custom-ds/ptFlex/assets/pcb-board-rendering.png

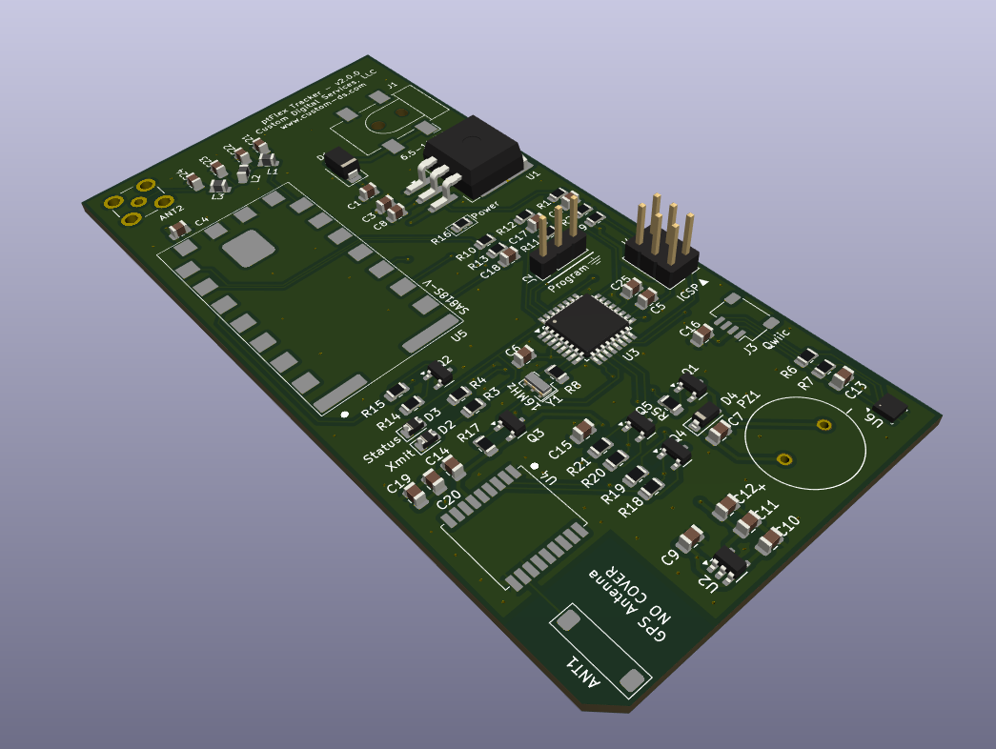
assets/pcb-board-rendering.png
