custom-ds/ptFlex/README.md

# ptFlex
ptFlex tracker board starting with version 2.0 of the hardware, which is based on the improvements found in the ptSolar tracker. This repo supercedes the original ptFlex-firmware and ptFlex-Hardware repos from the version 1.0 hardware.
