custom-ds/ptFlex/ptFlex/v1.0.4/README.md

# ptFlex v1.0.4

Final version of the 1.0 line of trackers, from the ptFlex-hardware project Repo on Github. The version 2.0 is an evolution of 1.0, but includes a new GPS engine, more readily available GPS antennas, and the circuit has been ported over to KiCad.
