custom-ds/ptFlex/assets/arduino-boards-manager2.png

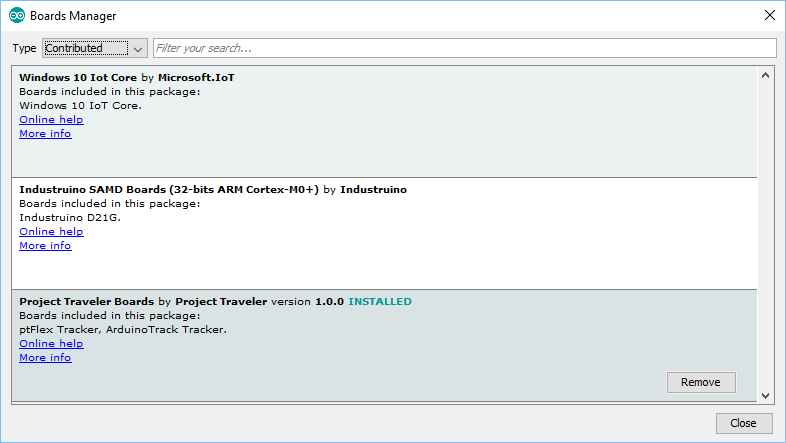
assets/arduino-boards-manager2.png
