custom-ds/ptFlex/assets/arduino-boards-manager-url.png

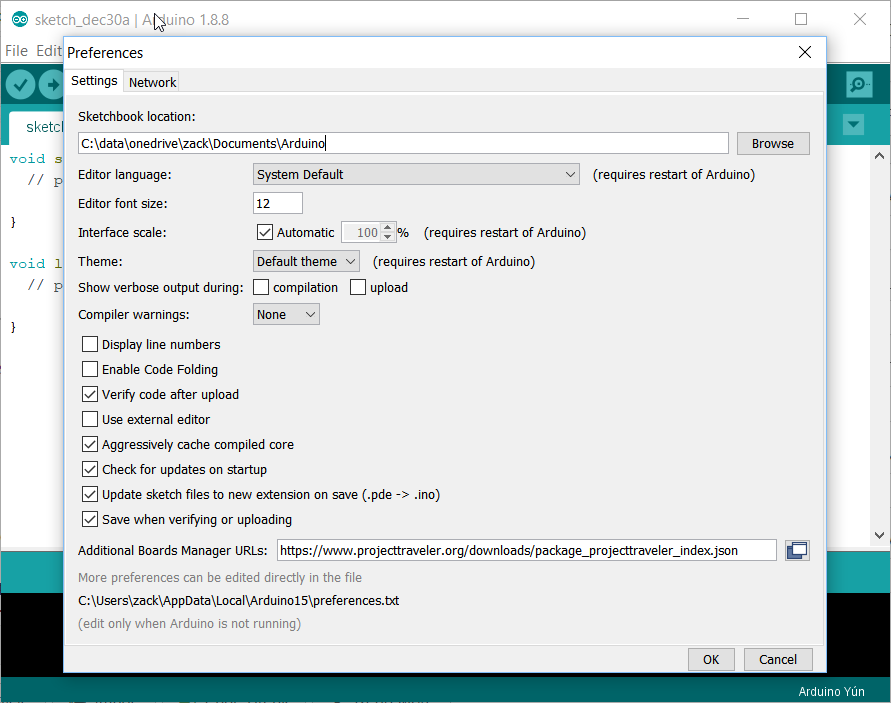
assets/arduino-boards-manager-url.png
