custom-ds/ptFlex/assets/schematic.png

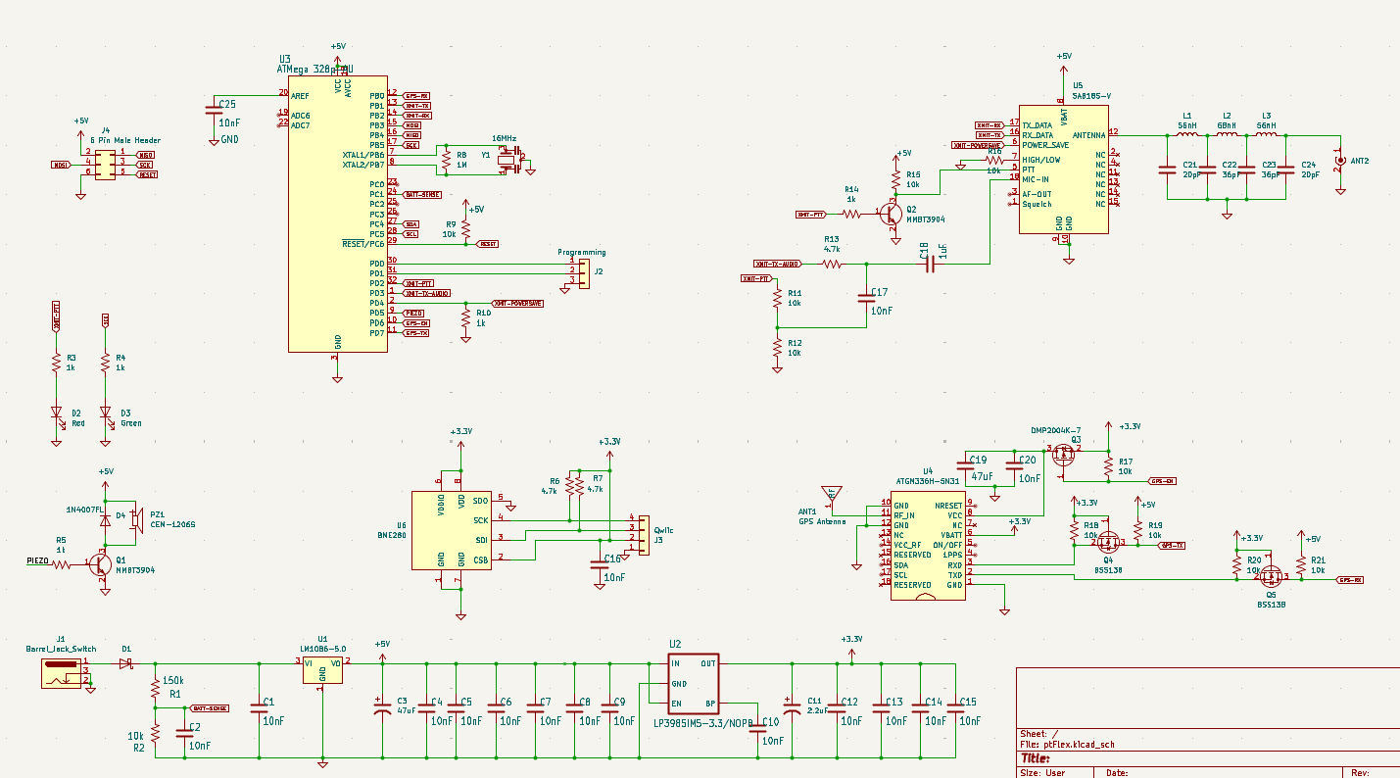
assets/schematic.png
