custom-ds/ptFlex/ptFlex/v2.0.2/schematic.pdf

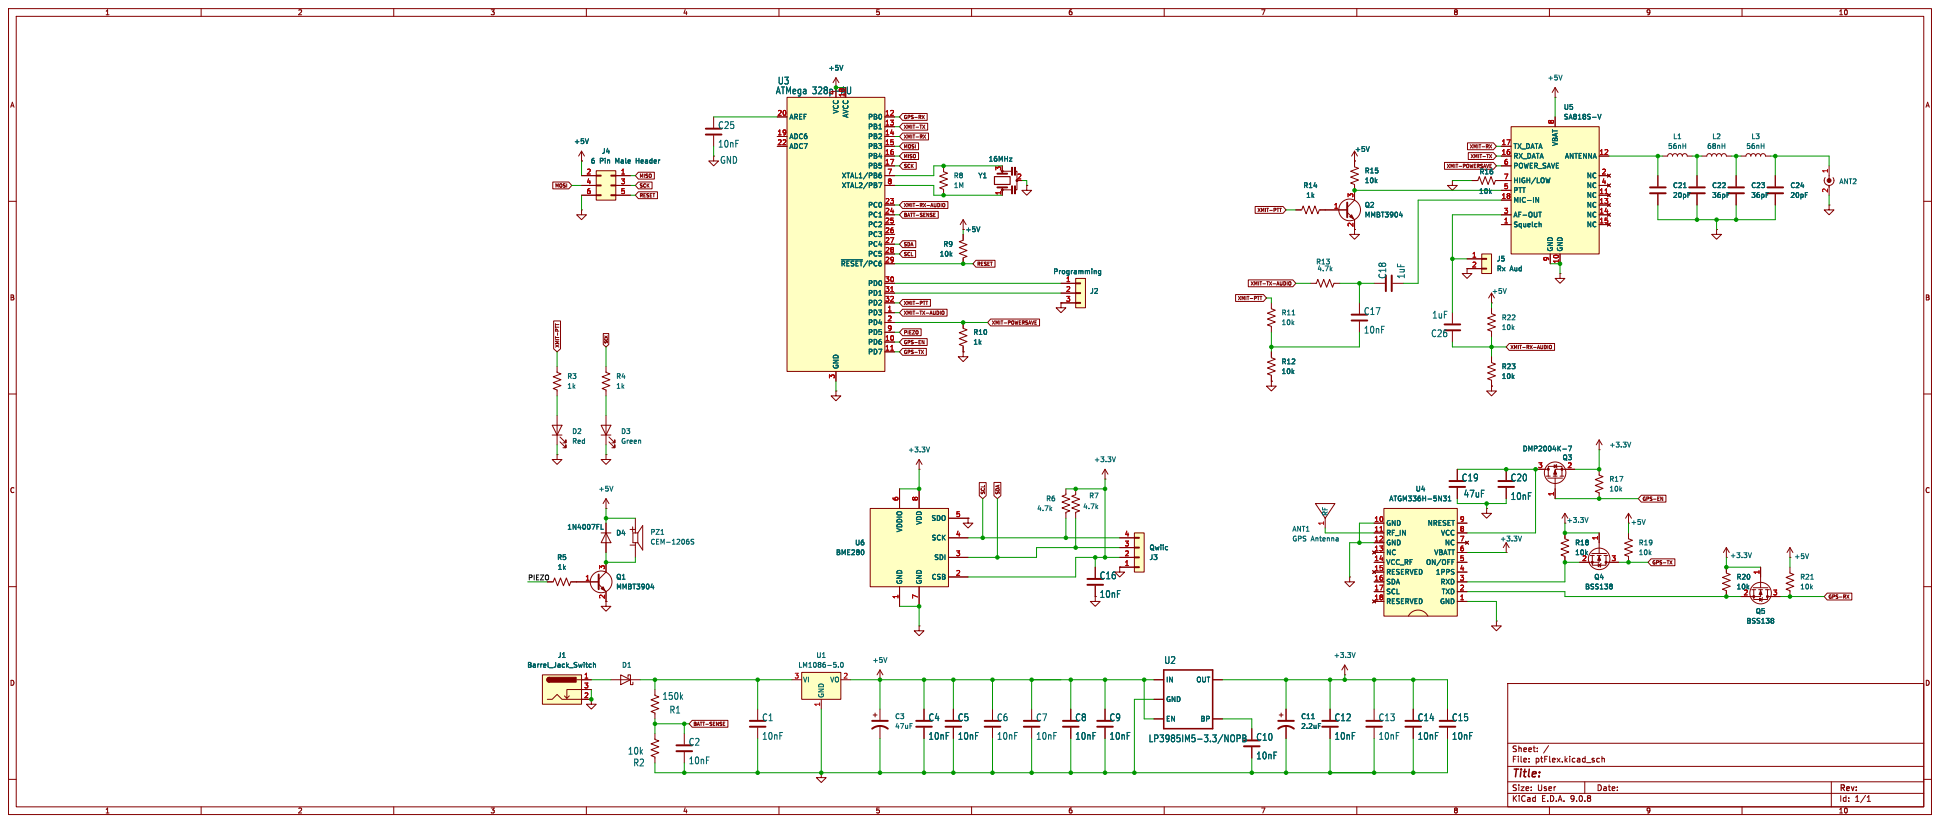
[picture p5: page 1]

XMIT-TX
XMIT-RX
SCL MOSI XMIT-TX-AUDIO
SCK MISO

J5Rx Aud +5V RF 1 ANT1 GPS Antenna

XMIT-PTT XMIT-TX-AUDIO

XMIT-PTT GPS-EN
