custom-ds/ptFlex/ptFlex/v2.0.2/pcb.pdf

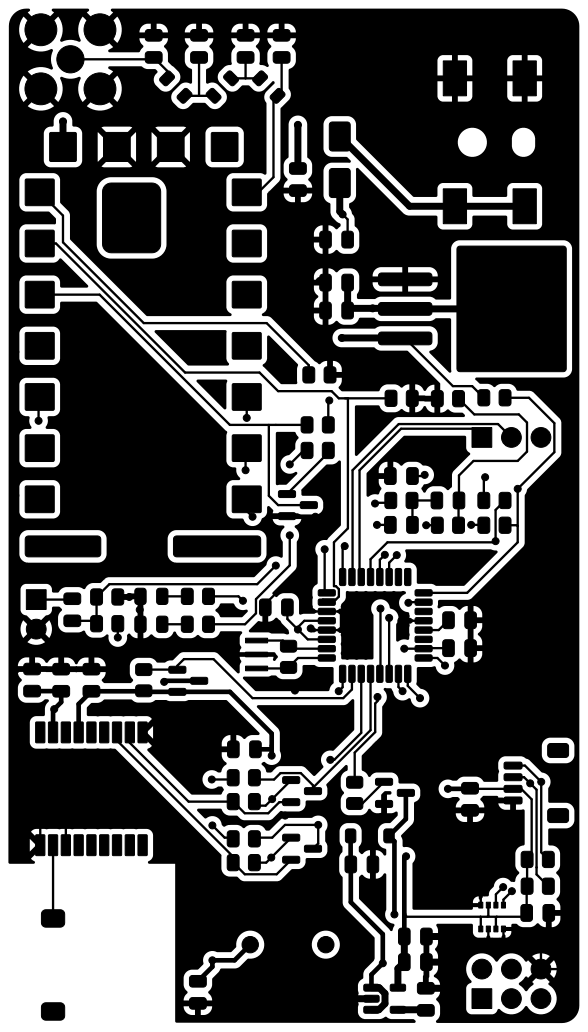
[picture p6: page 1]

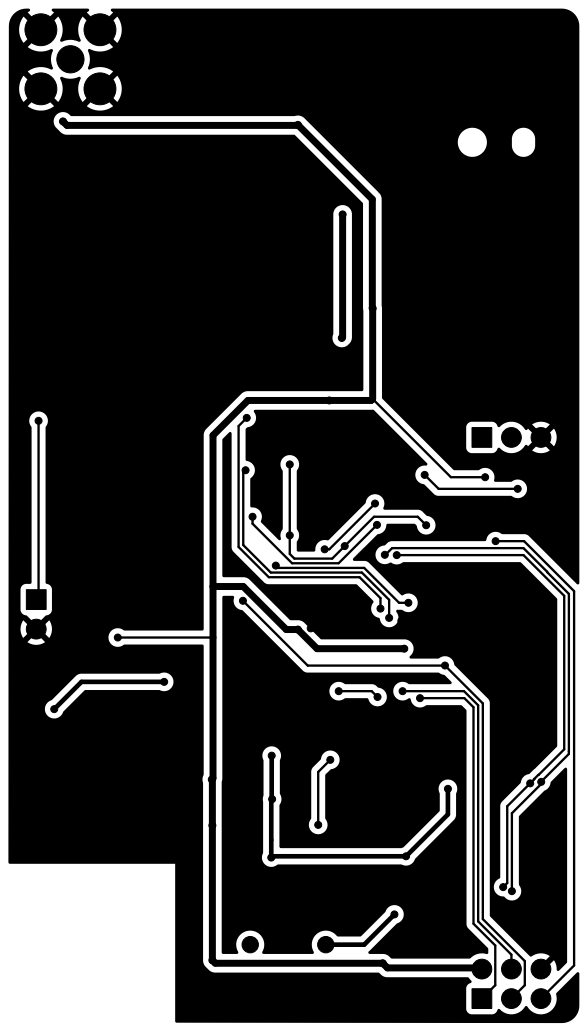
[picture p7: page 2]

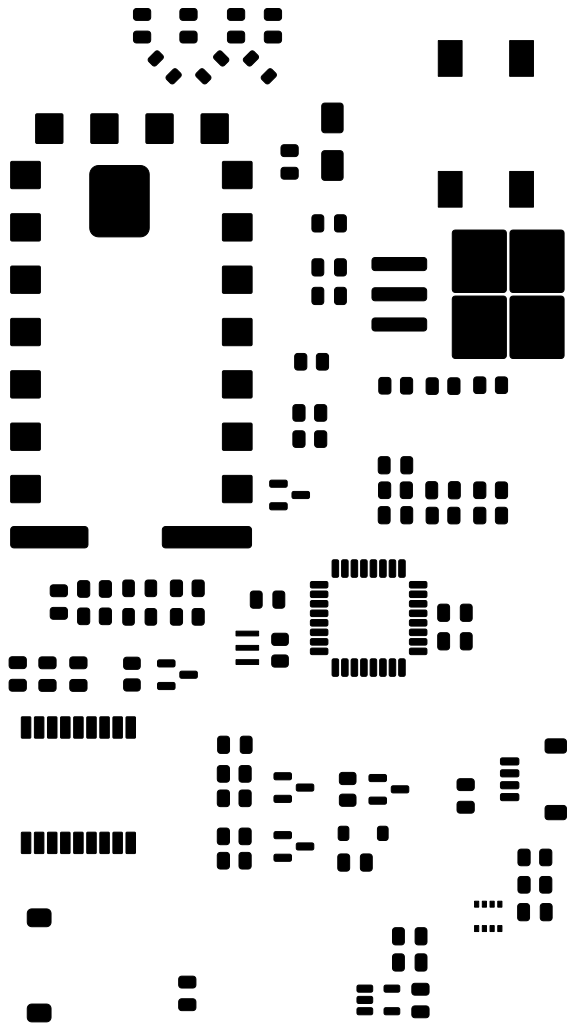
[picture p8: page 3]

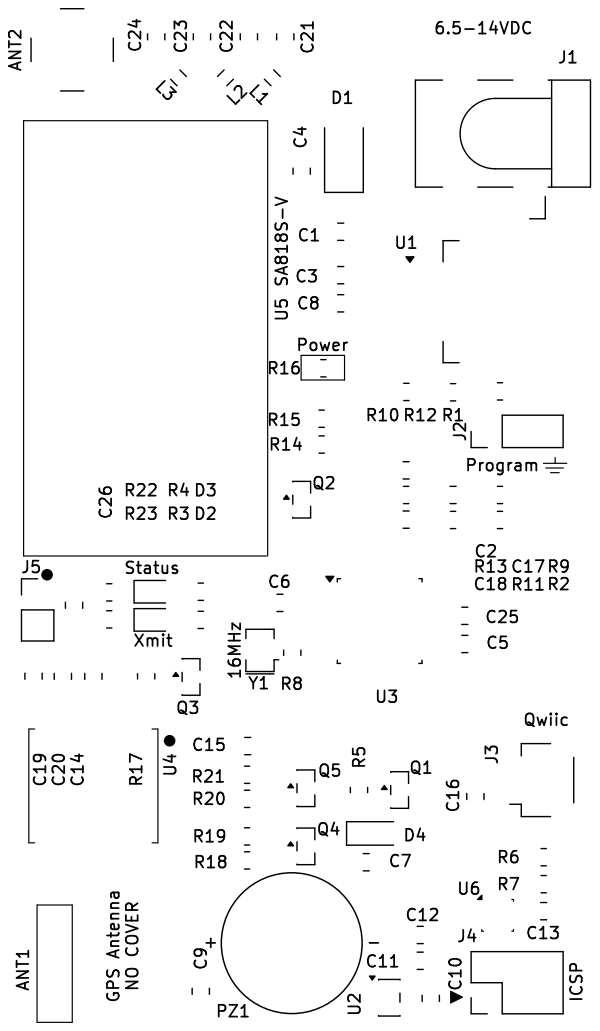
[picture p9: page 5]

Status GPS Antenna NO COVER

v2.0.2 - Tracker ptFlex LLC Services, Digital Custom

www.custom-ds.com

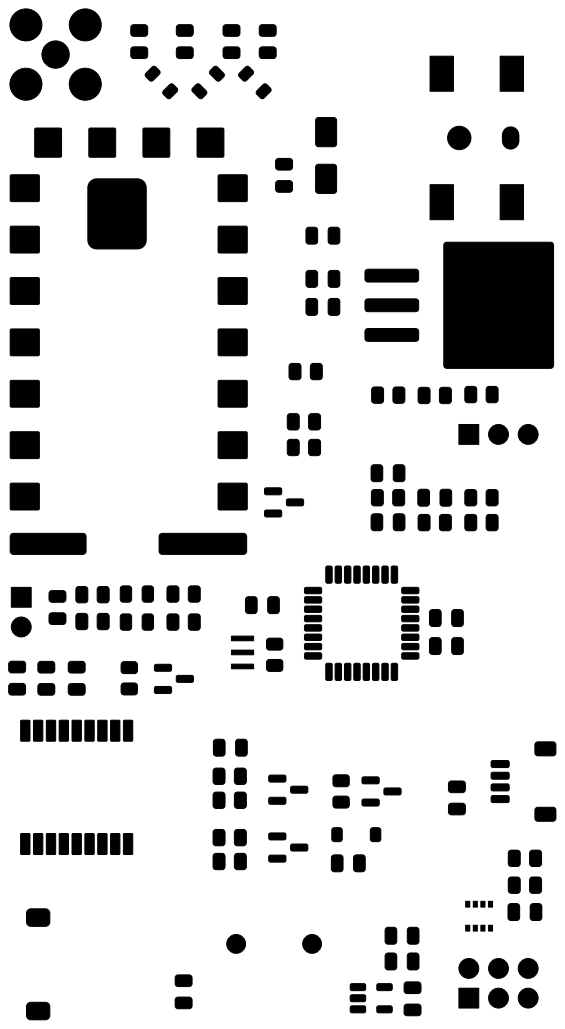
[picture p10: page 7]

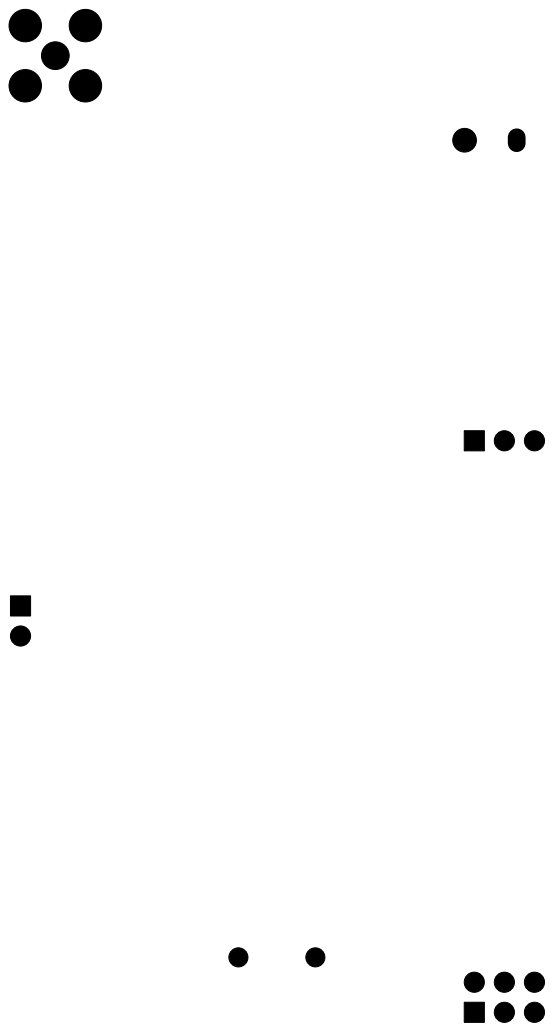
[picture p11: page 8]

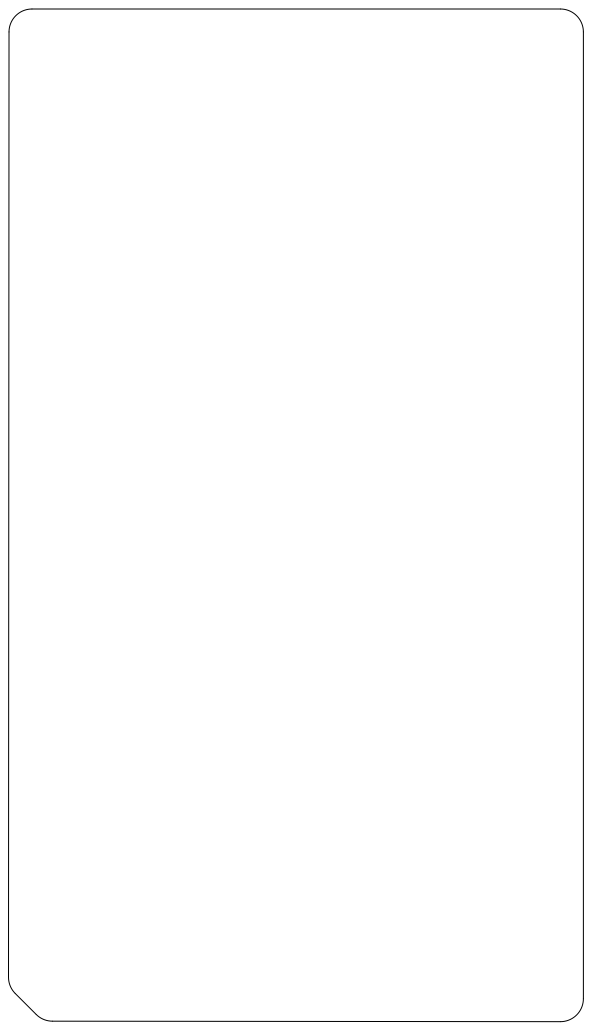
[picture p12: page 9]
