custom-ds/ptFlex/ptFlex/Current/pcb.pdf

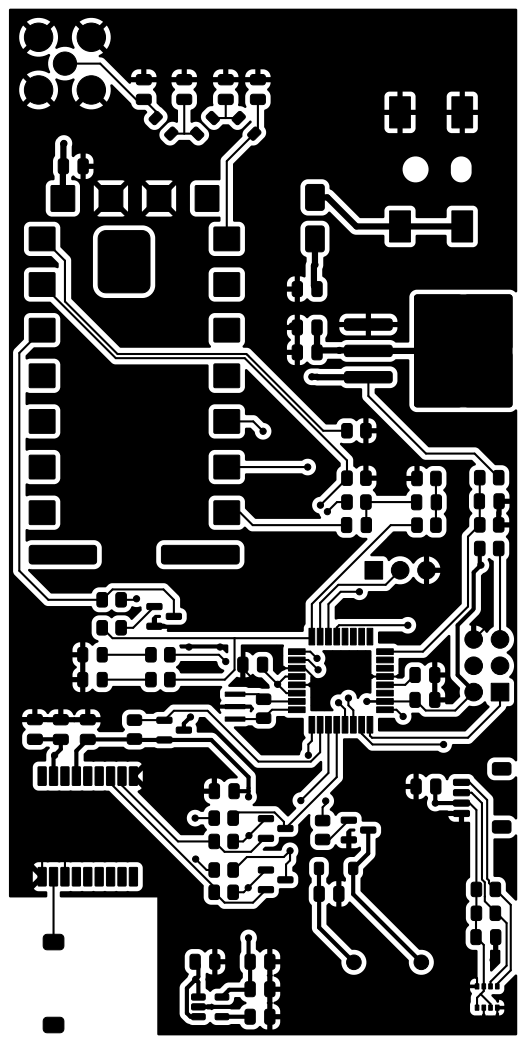
[picture p13: page 1]

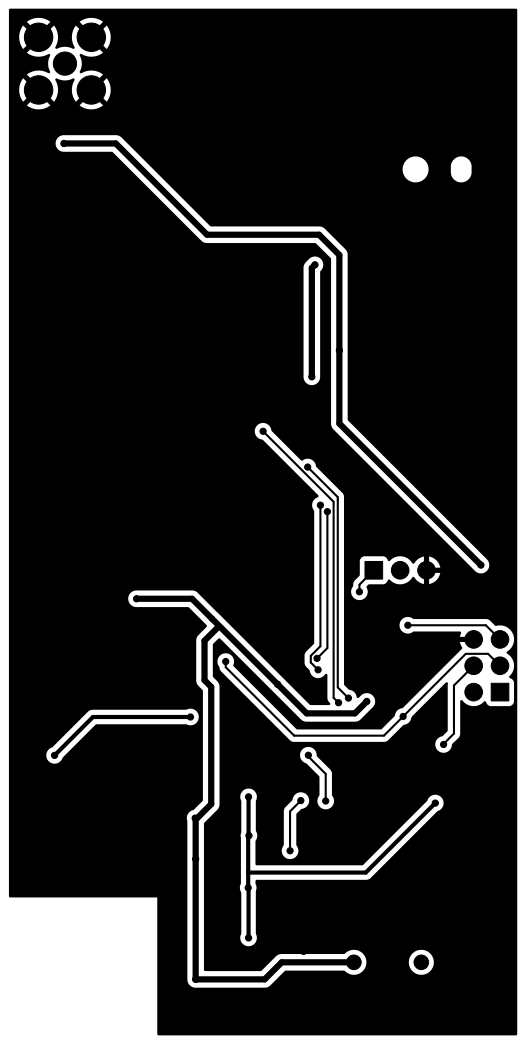
[picture p14: page 2]

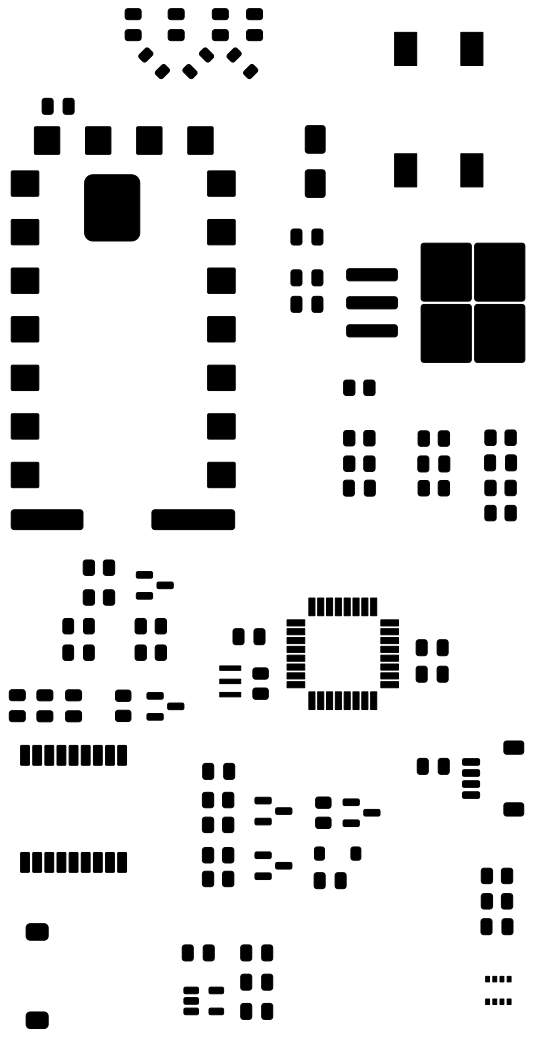
[picture p15: page 3]

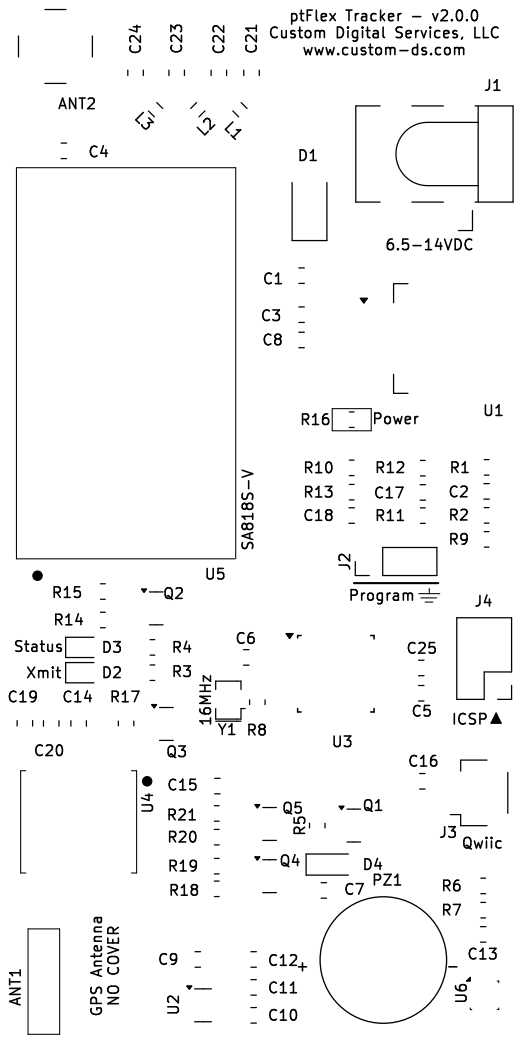
[picture p16: page 5]

www.custom-ds.com

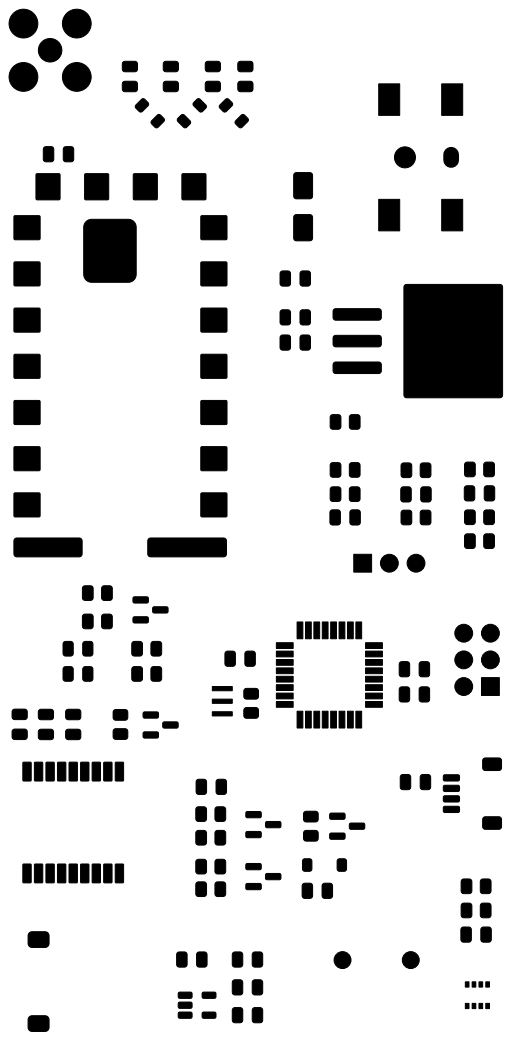
[picture p17: page 7]

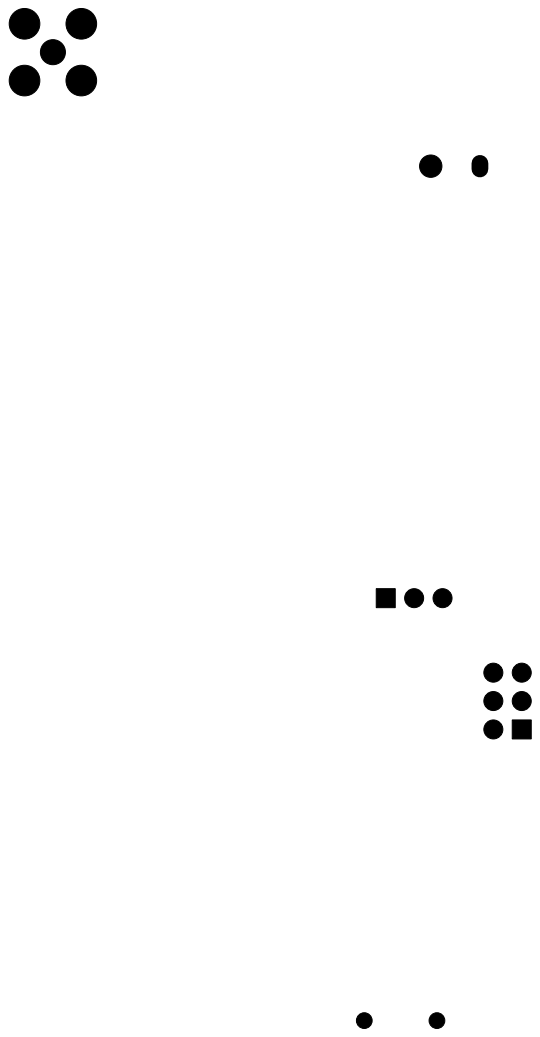
[picture p18: page 8]
