custom-ds/ptFlex/ptFlex/v1.0.4/schematic.pdf

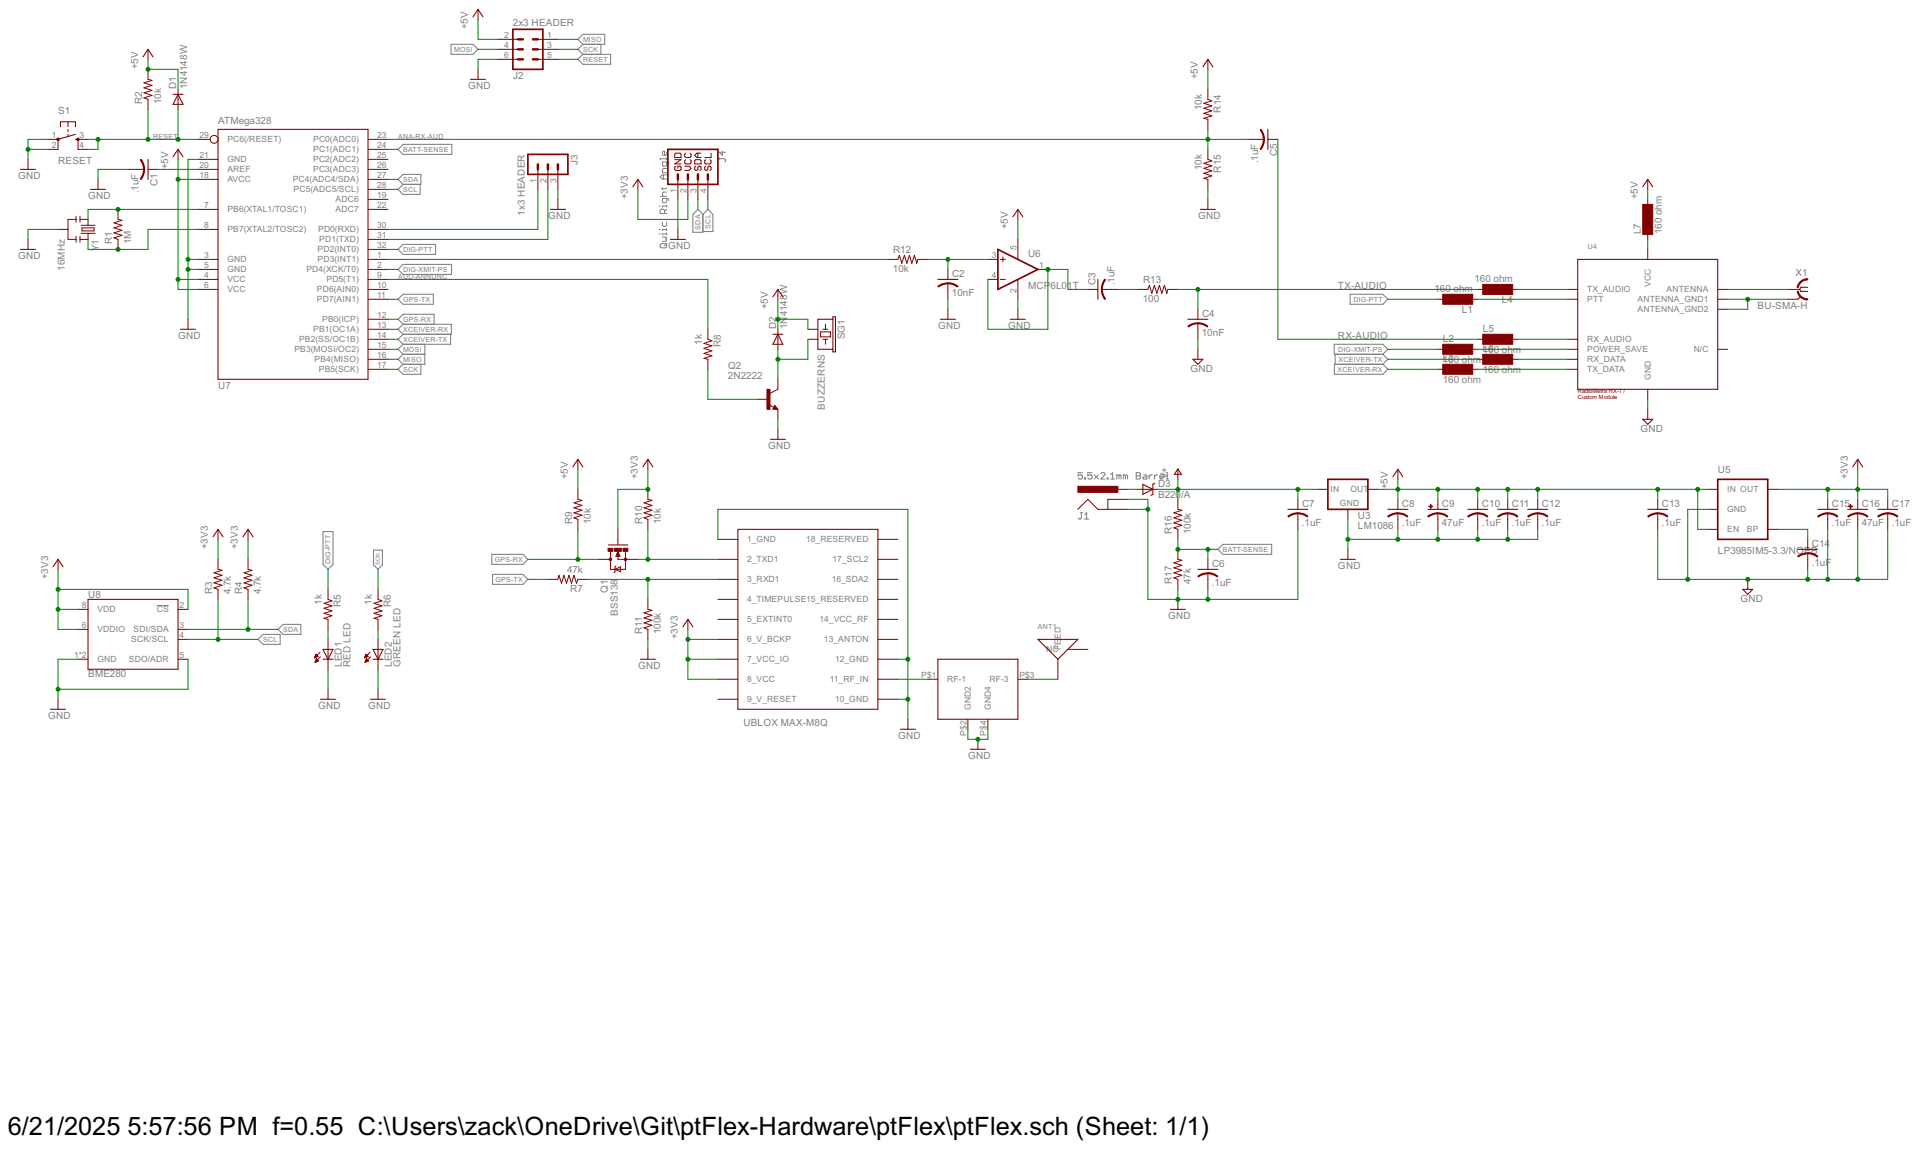
[picture p19: page 1]

XCEIVER-RX DIG-XMIT-PS
XCEIVER-TX

RadioMetrix HX-1 / Custom Module

RED LED GREEN LED

6/21/2025 5:57:56 PM f=0.55 C:\Users\zack\OneDrive\Git\ptFlex-Hardware\ptFlex\ptFlex.sch (Sheet: 1/1)
