custom-ds/ptFlex/ptFlex/v2.0.1/schematic.pdf

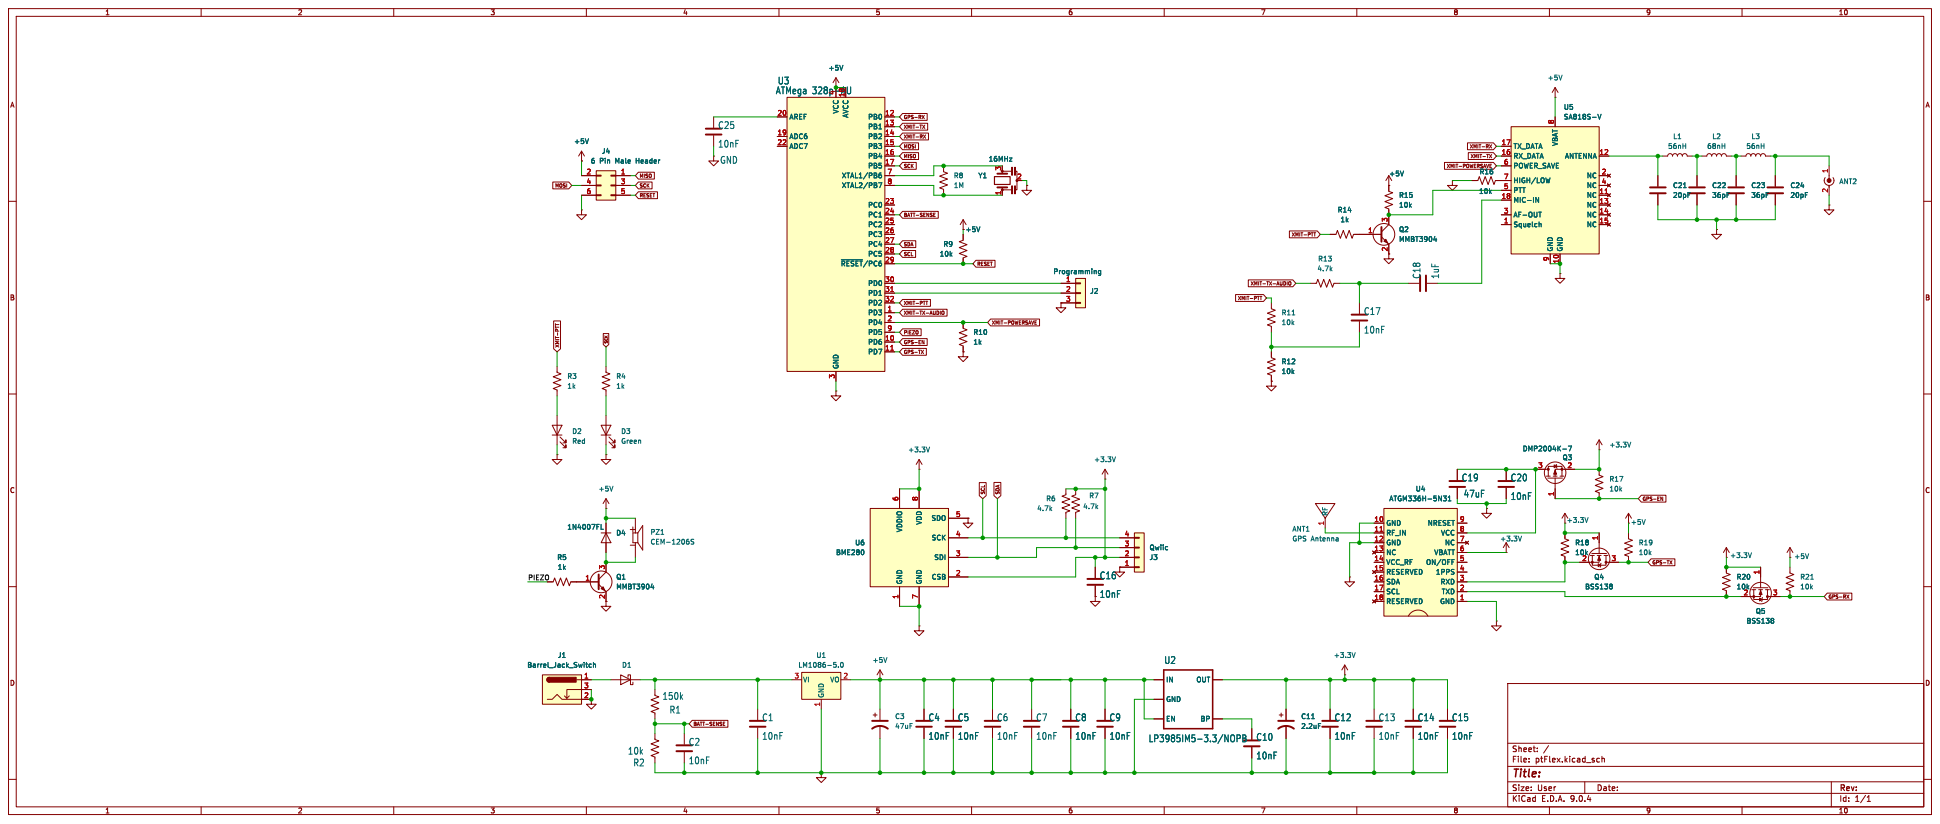
[picture p20: page 1]

GPS-RX
SCK MISO MOSI XMIT-TX

XMIT-PTT GPS-EN

XMIT-PTT XMIT-TX-AUDIO
