custom-ds/ptFlex/ptFlex/Current/schematic.pdf

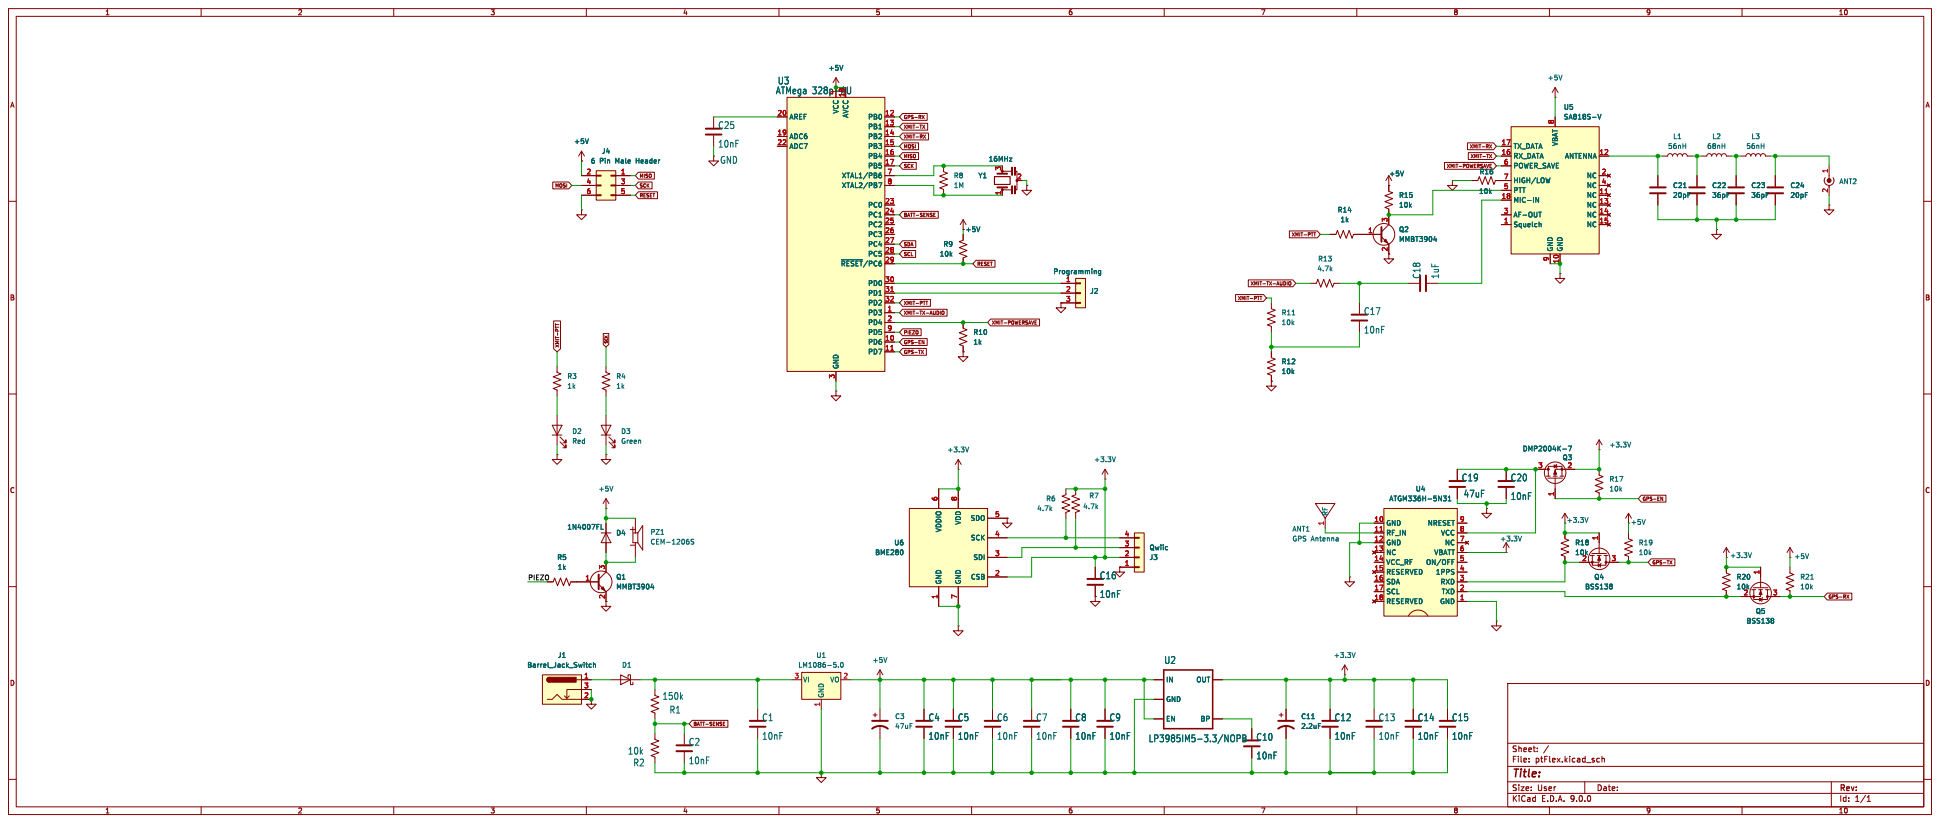
[picture p21: page 1]

XMIT-RX MOSI GPS-RX
XMIT-TX

XMIT-PTT XMIT-TX-AUDIO
