custom-ds/ptFlex/ptFlex/v2.0.1/pcb.pdf

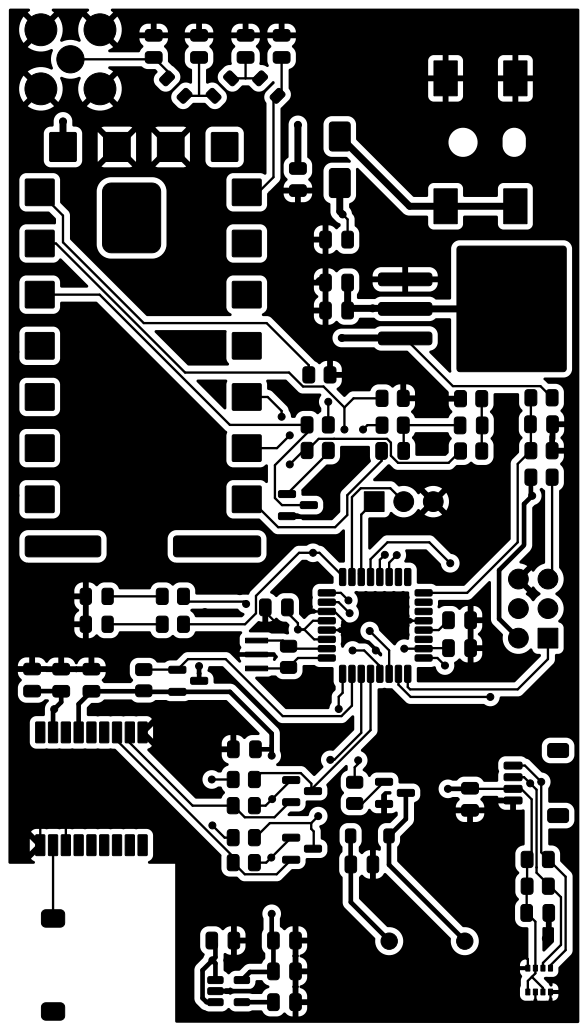
[picture p22: page 1]

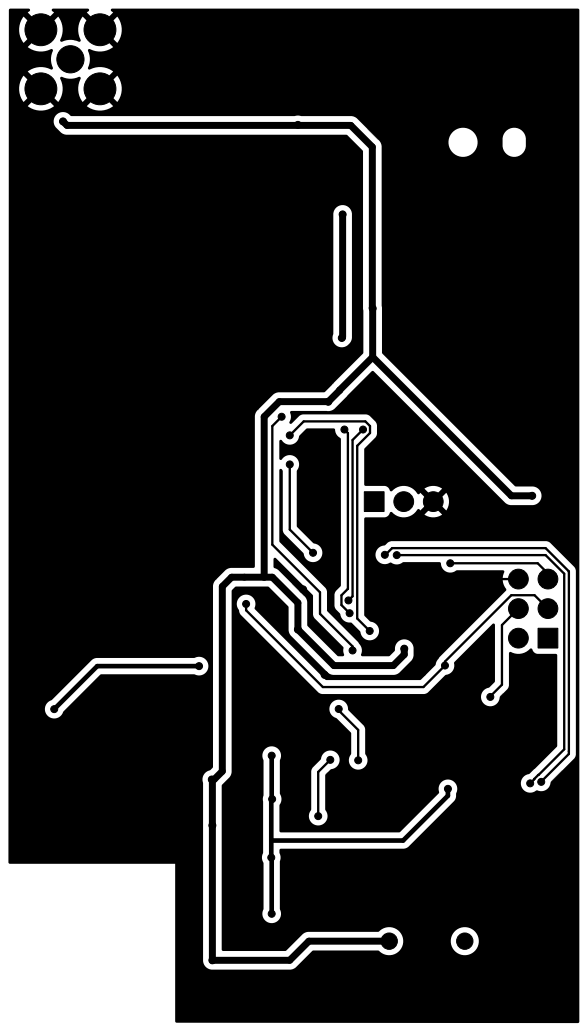
[picture p23: page 2]

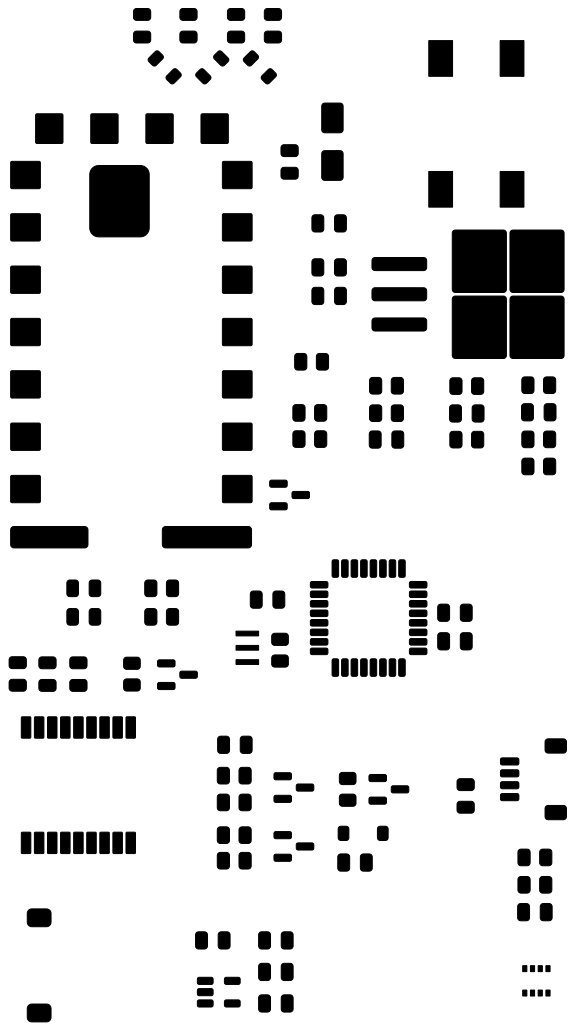
[picture p24: page 3]

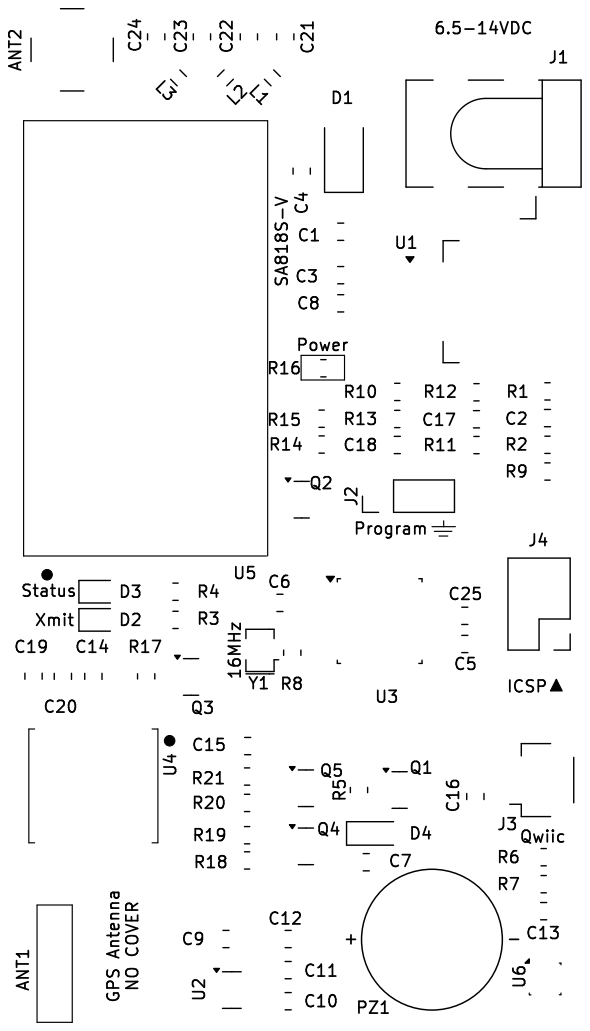
[picture p25: page 5]

v2.0.1 - Tracker ptFlex LLC Services, Digital Custom

www.custom-ds.com

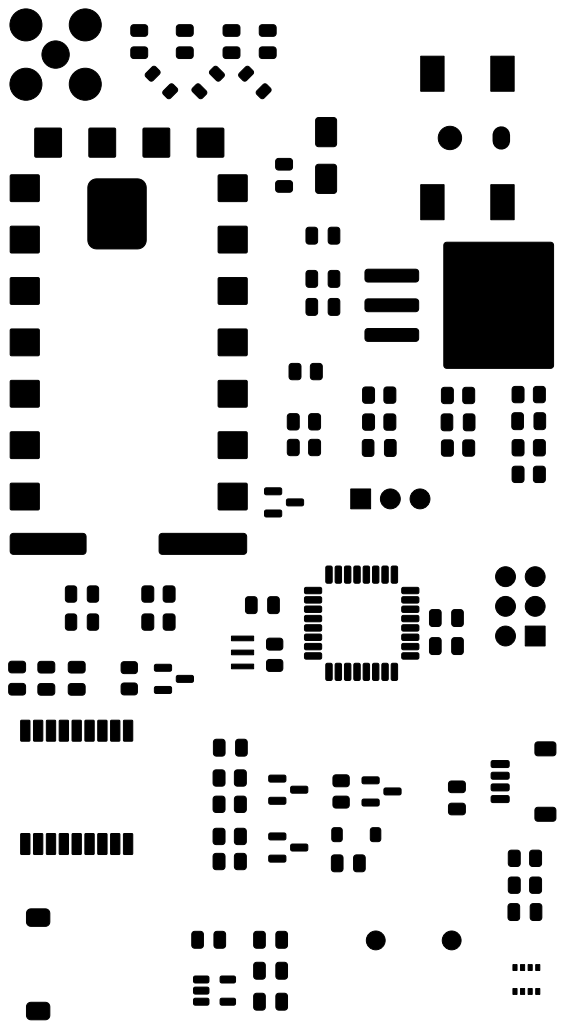
[picture p26: page 7]

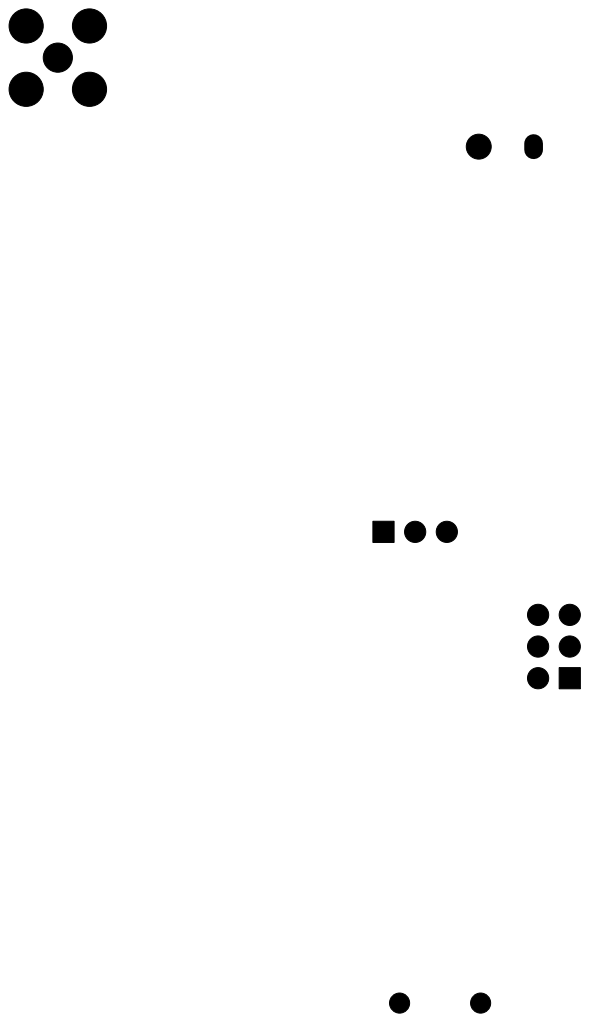
[picture p27: page 8]
