custom-ds/ptFlex/ptFlex/v1.0.4/pcb.pdf

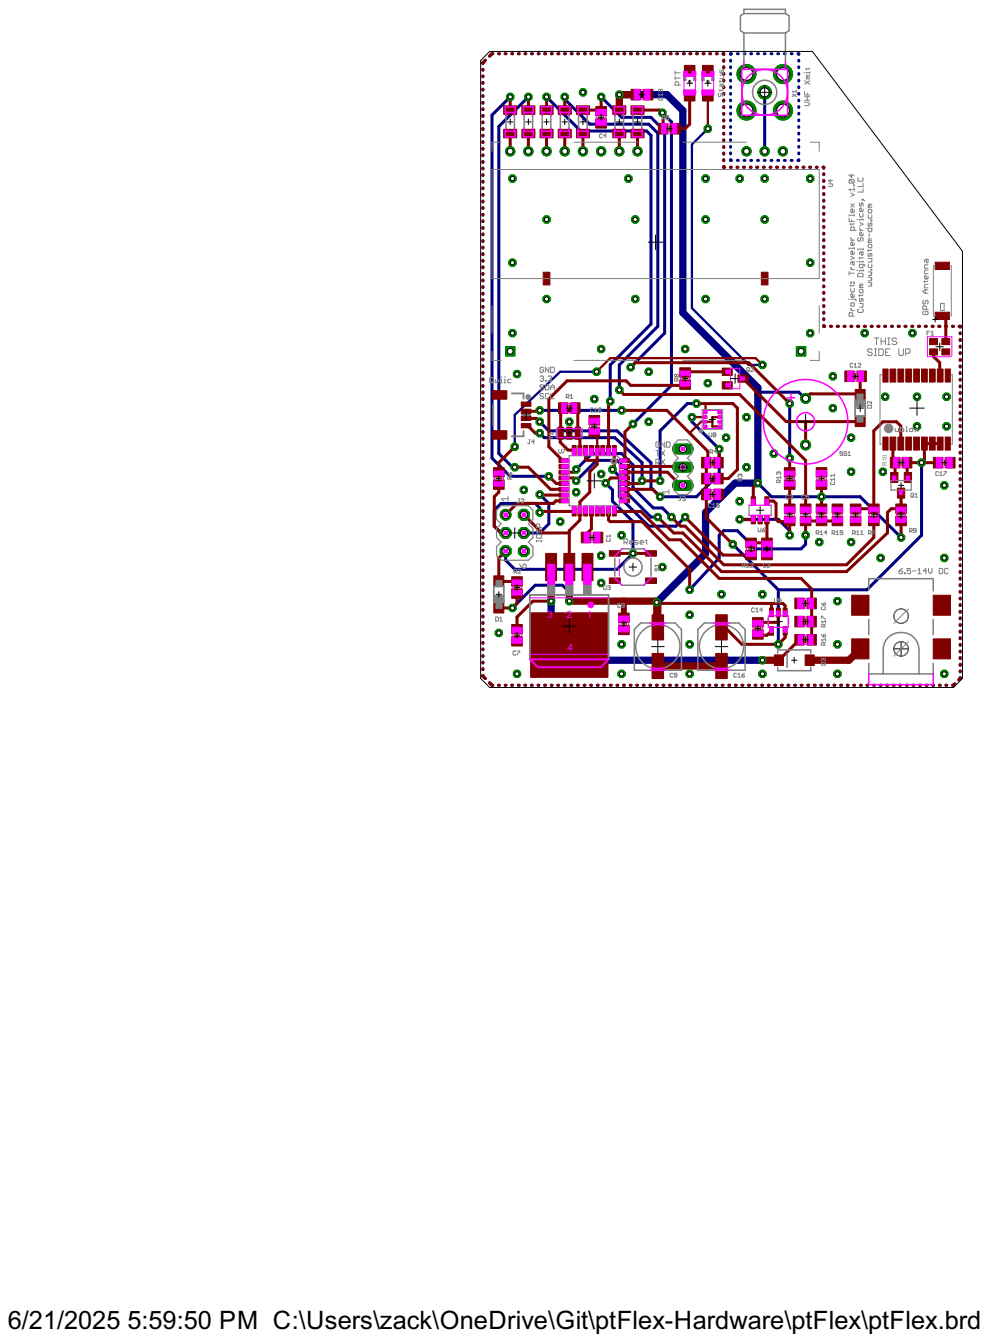
[picture p28: page 1]

6/21/2025 5:59:50 PM C:\Users\zack\OneDrive\Git\ptFlex-Hardware\ptFlex\ptFlex.brd
