custom-ds/ptFlex/ptFlex/ptFlex.kicad_pcb

## KiCad design ptFlex/ptFlex.kicad_pcb (2026-05-18)

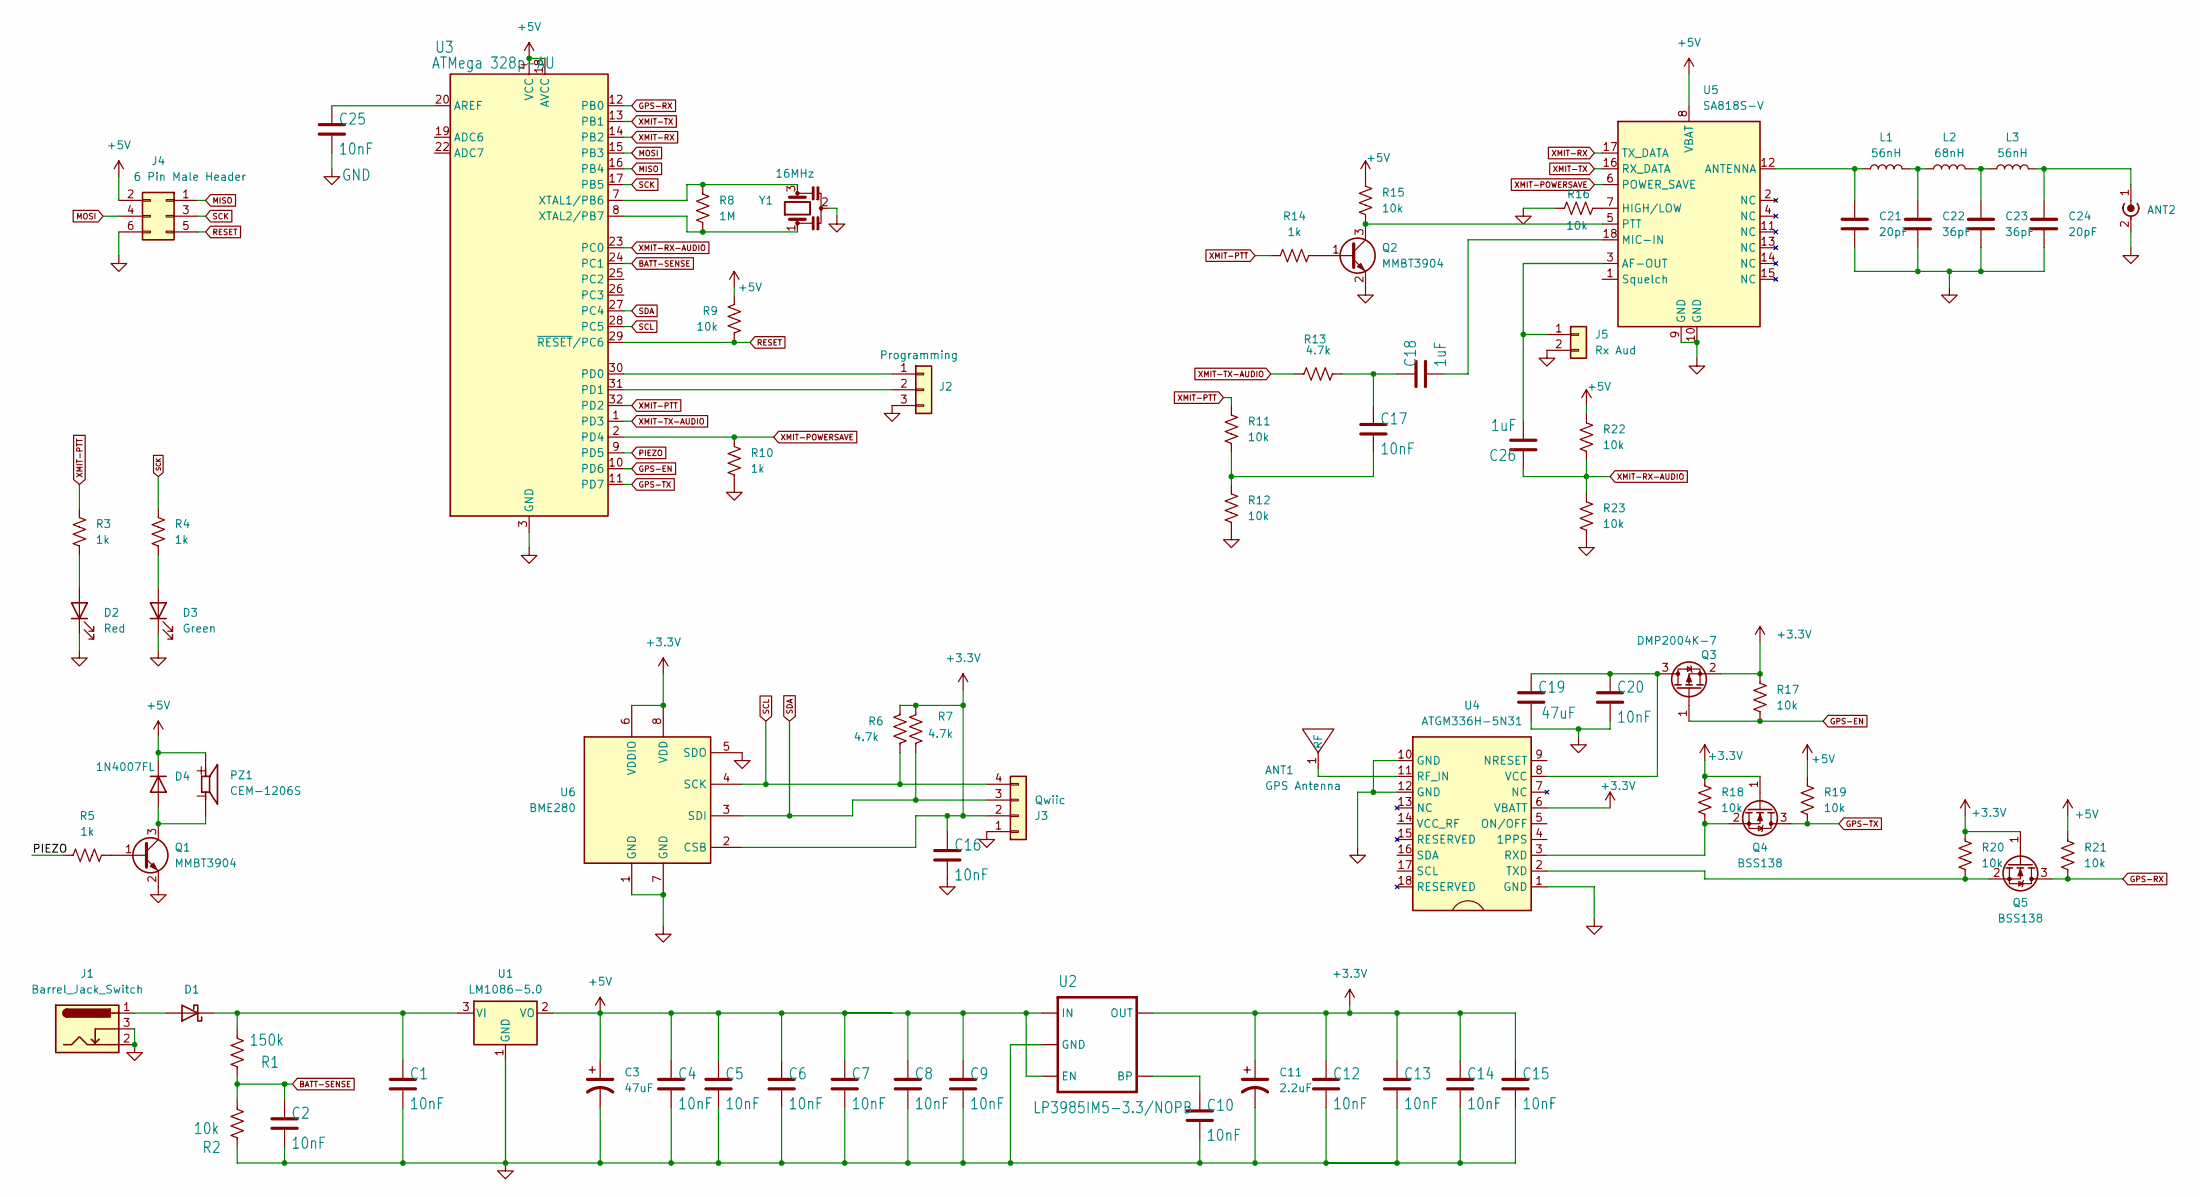
[picture p29: schematic ptFlex.kicad_sch]

Parts:
ANT1: GPS Antenna; Pulse ANT8010LL05R1575A Antenna; Digikey 553-ANT8010LL05R1575ACT-ND
ANT2: SMA Connector; SMA_Thru_Hole
C1, C2, C4, C5, C6, C7, C8, C9, C10, C12, C13, C14, C15, C16, C17, C20, C25: 10nF; C_0805_2012Metric; Digikey 399-1158-1-ND
C3, C19: 47uF; C_0805_2012Metric; Digikey 399-C0805C476M9PACTUCT-ND
C11: 2.2uF; C_0805_2012Metric; Digikey 445-1420-1-ND
C18, C26: 1uF; C_0805_2012Metric; Digikey 311-1886-1-ND
C21, C24: 20pF; C_0805_2012Metric; Digikey 712-1381-1-ND
C22, C23: 36pF; C_0805_2012Metric; Digikey 478-10473-1-ND
D1: CDBA340L-G Schottky; D_SMA; Digikey 641-1258-1-ND
D2: Red; D_0805_2012Metric; Digikey LTST-C171KRKT
D3: Green; D_0805_2012Metric; Digikey LTST-C171GKT
D4: 1N4007FL; D_SOD-123; Digikey 1655-1N4007FLCT-ND
J1: Barrel_Jack_Switch; BarrelJack_CLIFF_FC681465S_SMT_Horizontal; Digikey CP-002AHPJCT-ND
J2: Programming; PinHeader_1x03_P2.54mm_Vertical; Digikey 732-5316-ND
J3: Qwiic; JST_SH_SM04B-SRSS-TB_1x04-1MP_P1.00mm_Horizontal; Digikey 455-1804-1-ND
J4: 6 Pin Male Header; PinHeader_2x03_P2.54mm_Vertical; Digikey 732-5394-ND
J5: Rx Aud; PinHeader_1x02_P2.54mm_Vertical
L1, L3: 56nH; L_0805_2012Metric; Digikey 535-11570-1-ND
L2: 68nH; L_0805_2012Metric; Digikey 535-11572-1-ND
PZ1: CEM-1206S; CUI_CEM-1206S
Q1, Q2: MMBT3904; SOT-23; Digikey MMBT3904TPMSCT-ND
Q3: DMP2004K-7; SOT-23; Digikey DMP2004KDICT-ND
Q4, Q5: BSS138; SOT-23; Digikey BSS138TR-ND
R1: 150k; R_0805_2012Metric; Digikey 311-150KCRCT-ND
R2, R9, R11, R12, R15, R16, R17, R18, R19, R20, R21, R22, R23: 10k; R_0805_2012Metric; Digikey 13-RT0805FRD0710KLCT-ND
R3, R4, R5, R10, R14: 1k; R_0805_2012Metric; Digikey 311-1.0KARCT-ND
R6, R7, R13: 4.7k; R_0805_2012Metric; Digikey 311-4.7KARCT-ND
R8: 1M; R_0805_2012Metric; Digikey 311-1.0MARCT-ND
U1: LM1086-5.0; TO-263-3_TabPin2; Digikey LM1086ISX-5.0/NOPBCT-ND
U2: LP3985IM5-3.3/NOPB; SOT-23-5; Digikey LP3985IM5-3.3/NOPBCT-ND
U3: ATMega 328p-AU; TQFP-32_7x7mm_P0.8mm; Digikey ATMEGA328P-AU-ND
U4: ATGM336H-5N31; Digikey ALIEXPRESS
U5: SA818S-V; DRA818 SA818; Digikey ALIEXPRESS
U6: BME280; Bosch_LGA-8_2.5x2.5mm_P0.65mm_ClockwisePinNumbering; Digikey 828-1063-1-ND
Y1: 16MHz; Resonator_SMD_Murata_CSTxExxV-3Pin_3.0x1.1mm; Digikey 490-17948-2-ND

Connections:
+3.3V: C11.1, C12.1, C13.1, C14.1, C15.1, C16.1, J3.2, Q3.2 (S), Q4.1 (G), Q5.1 (G), R6.1, R7.1, R17.1, R18.2, R20.2, U2.5 (OUT), U4.6 (VBATT), U6.2 (CSB), U6.6 (VDDIO), U6.8 (VDD)
+5V: C3.1, C4.1, C5.1, C6.1, C7.1, C8.1, C9.1, D4.1 (K), J4.2, PZ1.P, R9.1, R15.2, R19.2, R21.2, R22.2, U1.2 (VO), U2.1 (IN), U2.3 (EN), U3.4 (VCC), U3.6 (VCC), U3.18 (AVCC), U5.8 (VBAT)
BATT-SENSE: C2.1, R1.1, R2.2, U3.24 (PC1)
GND: ANT2.2 (Ext), C1.2, C2.2, C3.2, C4.2, C5.2, C6.2, C7.2, C8.2, C9.2, C10.2, C11.2, C12.2, C13.2, C14.2, C15.2, C16.2, C19.2, C20.2, C21.1, C22.1, C23.1, C24.1, C25.2, D2.1 (K), D3.1 (K), J1.2, J1.3, J2.3, J3.1, J4.6, J5.2, Q1.2 (E), Q2.2 (E), R2.1, R10.1, R12.1, R16.1, R23.1, U1.1 (GND), U2.2 (GND), U3.3 (GND), U3.5 (GND), U3.21 (GND), U4.1 (GND), U4.10 (GND), U4.12 (GND), U5.9 (GND), U5.10 (GND), U6.1 (GND), U6.5 (SDO), U6.7 (GND), Y1.2
GPS-EN: Q3.1 (G), R17.2, U3.10 (PD6)
GPS-RX: Q5.3 (D), R21.1, U3.12 (PB0)
GPS-TX: Q4.3 (D), R19.1, U3.11 (PD7)
MISO: J4.1, U3.16 (PB4)
MOSI: J4.4, U3.15 (PB3)
unnamed: ANT1.1 (RF), U4.11 (RF_IN)
unnamed: ANT2.1 (In), C24.2, L3.2
unnamed: C17.1, C18.1, R13.2
unnamed: C17.2, R11.1, R12.2
unnamed: C22.2, L1.2, L2.1
unnamed: C23.2, L2.2, L3.1
unnamed: D1.2 (A), J1.1
unnamed: C1.1, D1.1 (K), R1.2, U1.3 (VI)
unnamed: D2.2 (A), R3.2
unnamed: D3.2 (A), R4.2
unnamed: D4.2 (A), PZ1.N, Q1.3 (C)
unnamed: J2.1, U3.30 (PD0)
unnamed: J2.2, U3.31 (PD1)
unnamed: C26.2, J5.1, U5.3 (AF-OUT)
unnamed: Q1.1 (B), R5.1
unnamed: Q2.1 (B), R14.2
unnamed: Q2.3 (C), R15.1, U5.5 (PTT)
unnamed: C19.1, C20.1, Q3.3 (D), U4.8 (VCC)
unnamed: Q4.2 (S), R18.1, U4.3 (RXD)
unnamed: Q5.2 (S), R20.1, U4.2 (TXD)
unnamed: C10.1, U2.4 (BP)
unnamed: C25.1, U3.20 (AREF)
unnamed: R8.1, U3.7 (XTAL1/PB6), Y1.3
unnamed: R8.2, U3.8 (XTAL2/PB7), Y1.1
unnamed: C21.2, L1.1, U5.12 (ANTENNA)
unnamed: R16.2, U5.7 (HIGH/LOW)
unnamed: C18.2, U5.18 (MIC-IN)
PIEZO: R5.2, U3.9 (PD5)
RESET: J4.5, R9.2, U3.29 (~RESET/PC6)
SCK: J4.3, R4.1, U3.17 (PB5)
SCL: J3.4, R6.2, U3.28 (PC5), U6.4 (SCK)
SDA: J3.3, R7.2, U3.27 (PC4), U6.3 (SDI)
XMIT-POWERSAVE: R10.2, U3.2 (PD4), U5.6 (POWER_SAVE)
XMIT-PTT: R3.1, R11.2, R14.1, U3.32 (PD2)
XMIT-RX: U3.14 (PB2), U5.17 (TX_DATA)
XMIT-RX-AUDIO: C26.1, R22.1, R23.2, U3.23 (PC0)
XMIT-TX: U3.13 (PB1), U5.16 (RX_DATA)
XMIT-TX-AUDIO: R13.1, U3.1 (PD3)

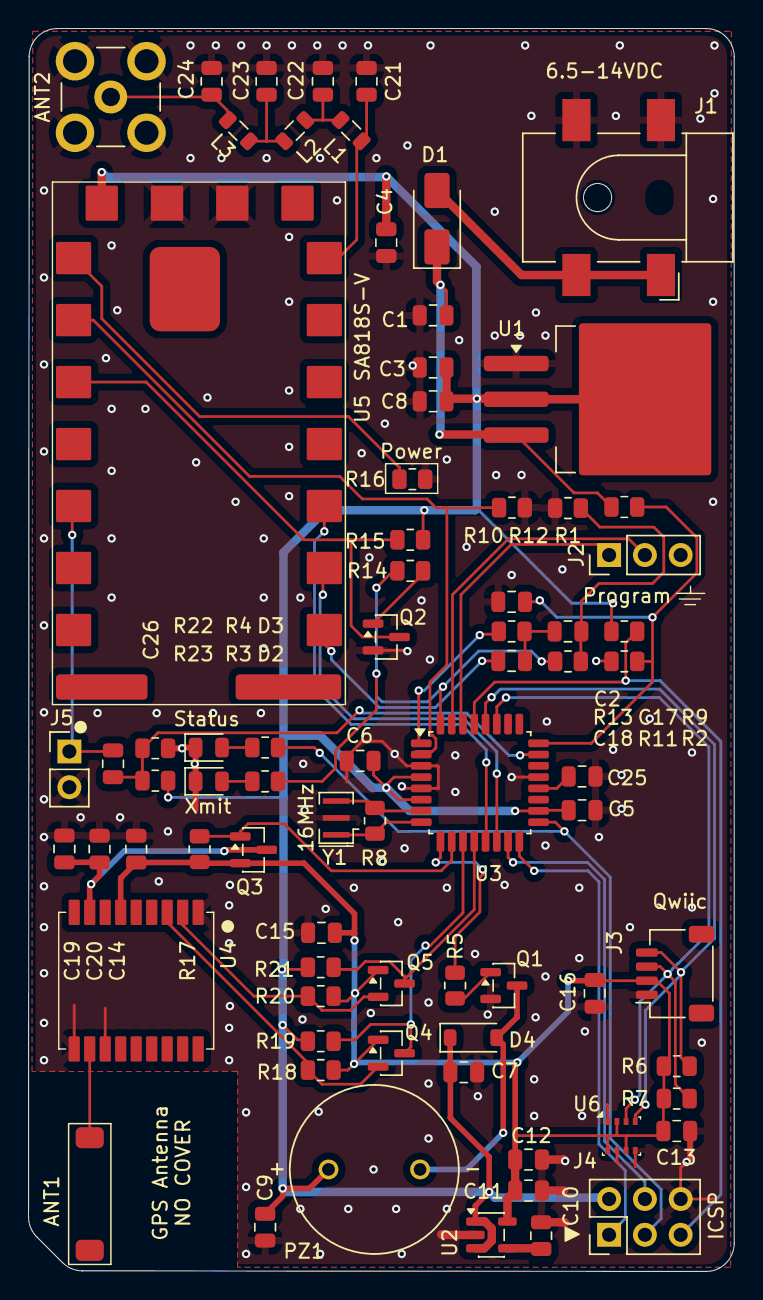
[picture p30: board ptFlex.kicad_pcb from above]

Board: 2 copper layers, 50.1 x 88.2 mm, 76 parts (0 on the bottom side), 47 nets.
