custom-ds/ptFlex/ptFlex/v1.0.4/ptFlex.brd

## EAGLE design ptFlex/v1.0.4/ptFlex.brd (2025-06-22, an earlier design)

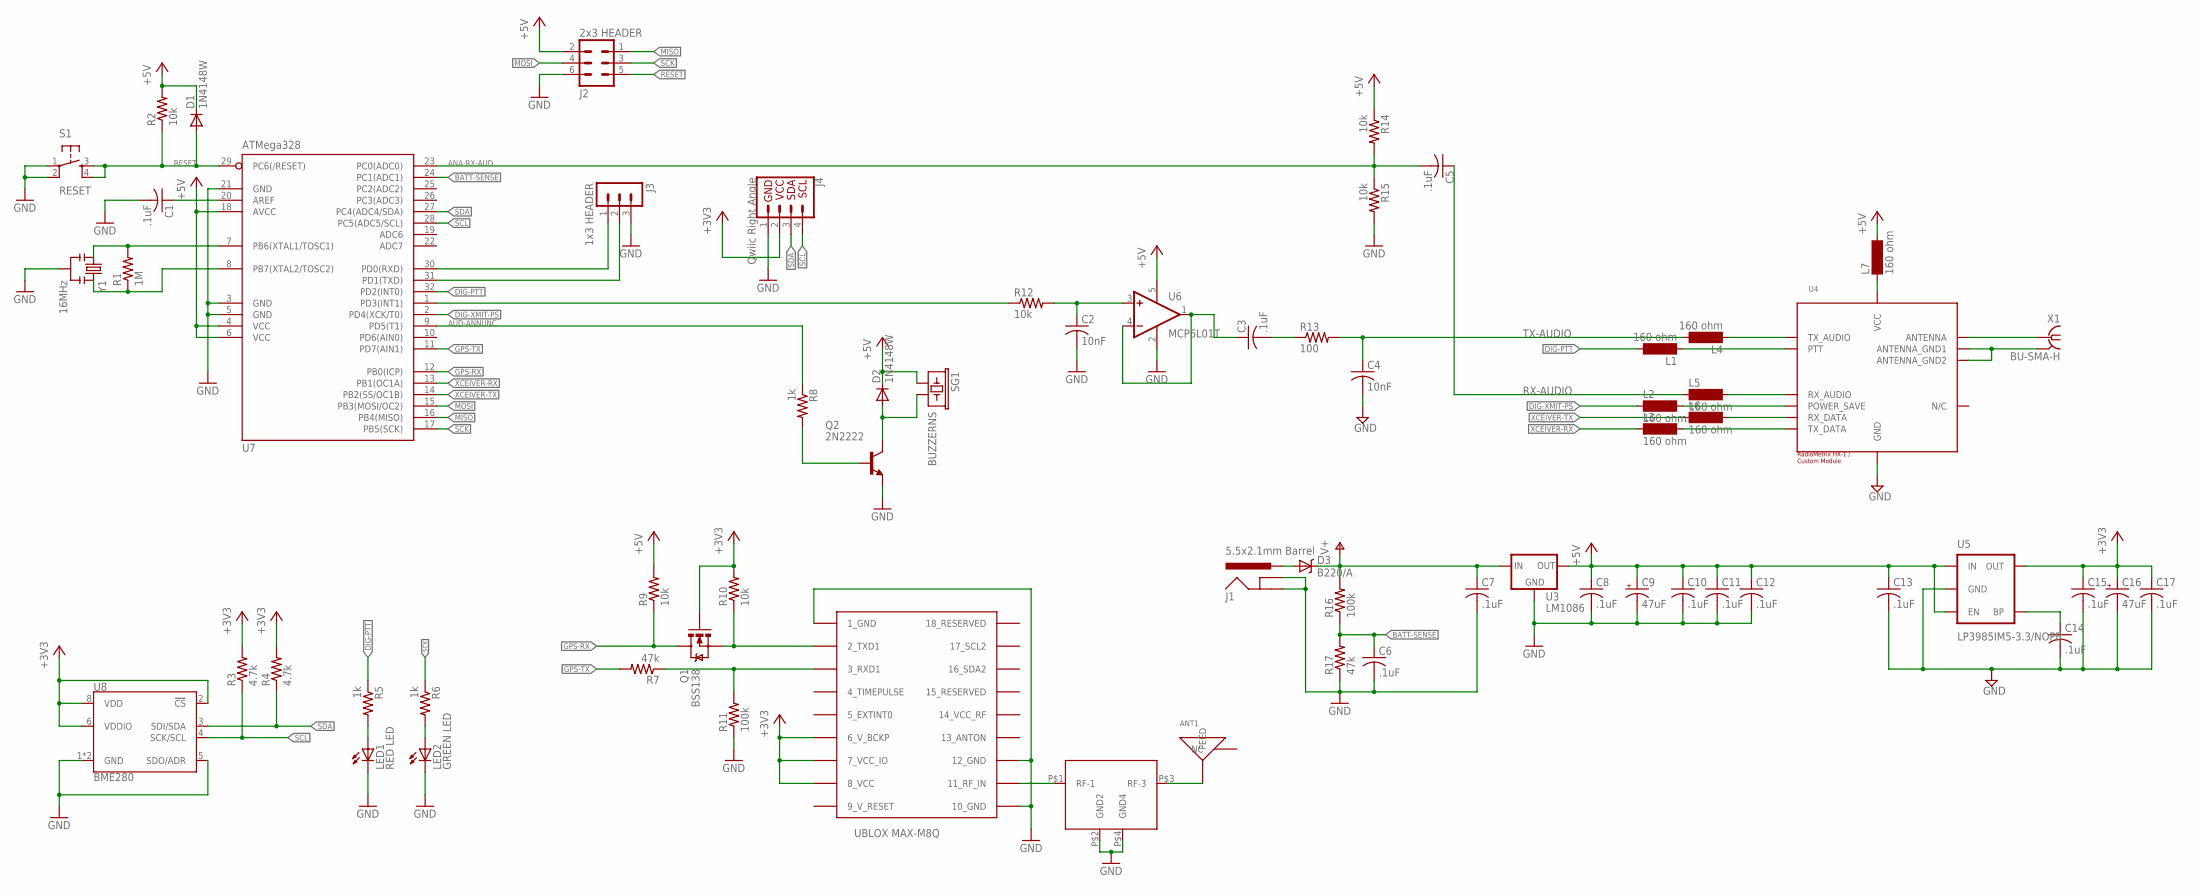
[picture p31: schematic ptFlex.sch]

Parts:
ANT1: GPS ANTENNA; 1575AT43A40; DIGIKEY 712-1003-1-ND
C1, C3, C5, C6, C7, C8, C10, C11, C12, C13, C14, C15, C17: .1uF; C0805; DIGIKEY 311-1361-1-ND
C2, C4: 10nF; C0805; DIGIKEY 399-1158-1-ND
C9, C16: 47uF; 153CLV-0605; DIGIKEY PCE3842CT-ND
D1, D2: 1N4148W; SOD123; DIGIKEY 1N4148W-FDICT-ND
D3: B220/A; SMA-DIODE; DIGIKEY 641-1258-1-ND
F1: MURATA-GPS-FILTER; DIGIKEY 583-1198-1-ND
J1: 5.5x2.1mm Barrel; POWER_JACK_SMD; DIGIKEY CP-002AHPJCT-ND
J2: 2x3 HEADER; MA03-2; DIGIKEY 952-2121-ND
J3: 1x3 HEADER; MA03-1; DIGIKEY 952-2264-ND
J4: Qwiic Right Angle; 1X04_1MM_RA; DIGIKEY 455-1804-1-ND
L1, L2, L3, L4, L5, L6, L7: 160 ohm; SM-1206; DIGIKEY 240-2411-1-ND
LED1: RED LED; CHIPLED_1206; DIGIKEY 160-1405-1-ND
LED2: GREEN LED; CHIPLED_1206; DIGIKEY 160-1169-1-ND
Q1: BSS138; SOT23; DIGIKEY BSS138KCT-ND
Q2: 2N2222; SOT23-BEC; DIGIKEY MMBT2222AFSCT-ND
R1: 1M; R0805; DIGIKEY 311-1.0MARCT-ND
R2, R9, R10, R12, R14, R15: 10k; R0805; DIGIKEY 311-10.0KCRCT-ND
R3, R4: 4.7k; R0805; DIGIKEY 311-4.7KARCT-ND
R5, R6, R8: 1k; R0805; DIGIKEY 311-1.0KARCT-ND
R7, R17: 47k; R0805; DIGIKEY 311-47.0KCRCT-ND
R11, R16: 100k; R0805; DIGIKEY 311-100KCRCT-ND
R13: 100; R0805; DIGIKEY 311-100ARCT-ND
S1: RESET; TACTILE_SWITCH_SMD; DIGIKEY CKN9104CT-ND
SG1: BUZZERNS; BUZZER-12MM-NS; DIGIKEY 102-1155-ND
U2: UBLOX_MAX; DIGIKEY 672-1003-1-ND
U3: LM1086; TO263; DIGIKEY LM1086ISX-5.0/NOPBCT-ND
U4: RADIOMETRIX-HX1-CUSTOM
U5: LP3985IM5-3.3/NOPB; SOT23-5; DIGIKEY LP3985IM5-3.3/NOPBCT-ND
U6: MCP6L01T; SOT23-5; DIGIKEY MCP6L01T-E/OTCT-ND
U7: ATMega328; TQFP32-08; DIGIKEY ATMEGA328P-AU-ND
U8: BME280; LGA-8-2.5X2.5; DIGIKEY 828-1063-1-ND
X1: BU-SMA-H; DIGIKEY CONSMA001-ND
Y1: 16MHz; RESONATOR-SMD; DIGIKEY 478-5420-1-ND

Connections:
9_V_RESET: U2.9_V_RESET
+3V3: C15.1, C16.+, C17.1, J4.2, Q1.1 (G), R3.2, R4.2, R10.2, U2.6_V_BCKP, U2.7_VCC_IO, U2.8_VCC, U5.5 (OUT), U8.2 (!CS), U8.6 (VDDIO), U8.8 (VDD)
+5V: C8.1, C9.+, C10.1, C11.1, C12.1, C13.1, D1.C, D2.C, J2.2, L7.2, R2.2, R9.2, R14.1, SG1.+ (1), U3.2 (OUT), U5.1 (IN), U5.3 (EN), U6.5 (V+), U7.4 (VCC), U7.6 (VCC), U7.18 (AVCC)
ANA-RX-AUD: C5.2, R14.2, R15.1, U7.23 (PC0(ADC0))
AUD-ANNUNC: R8.1, U7.9 (PD5(T1))
BATT-SENSE: C6.1, R16.1, R17.2, U7.24 (PC1(ADC1))
DIG-PTT: L1.2, R5.1, U7.32 (PD2(INT0))
DIG-XMIT-PS: L2.1, U7.2 (PD4(XCK/T0))
GND: C1.2, C2.2, C4.2, C6.2, C7.2, C8.2, C9.-, C10.2, C11.2, C12.2, C13.2, C14.2, C15.2, C16.-, C17.2, F1.P$2 (GND2), F1.P$4 (GND4), J1.GND (GNDBREAK), J1.P$4 (GND), J2.6, J3.3, J4.1, LED1.C, LED2.C, Q2.E, R11.1, R15.2, R17.1, S1.1, S1.2, U2.1_GND, U2.10_GND, U2.12_GND, U3.1 (GND), U4.GND, U5.2 (GND), U6.2 (V-), U7.3 (GND), U7.5 (GND), U7.21 (GND), U8.1 (GND), U8.5 (SDO/ADR), U8.7 (GND), Y1.2
GPS-RX: Q1.3 (D), R9.1, U7.12 (PB0(ICP))
GPS-TX: R7.2, U7.11 (PD7(AIN1))
MISO: J2.1, U7.16 (PB4(MISO))
MOSI: J2.4, U7.15 (PB3(MOSI/OC2))
unnamed: C2.1, R12.2, U6.3 (+IN)
unnamed: F1.P$1 (RF-1), U2.11_RF_IN
unnamed: ANT1.FEED, F1.P$3 (RF-3)
unnamed: U4.ANTENNA, X1.1
unnamed: L4.1, U4.TX_AUDIO
unnamed: L1.1, U4.PTT
unnamed: D3.A, J1.VIN0 (PWR)
unnamed: D2.A, Q2.C, SG1.- (2)
unnamed: C4.1, L4.2, R13.2
unnamed: C3.1, U6.1 (OUT), U6.4 (-IN)
unnamed: L5.2, U4.RX_AUDIO
unnamed: R12.1, U7.1 (PD3(INT1))
unnamed: L2.2, U4.POWER_SAVE
unnamed: Q1.2 (S), R10.1, U2.2_TXD1
unnamed: R1.1, U7.8 (PB7(XTAL2/TOSC2)), Y1.3
unnamed: R7.1, R11.2, U2.3_RXD1
unnamed: L6.2, U4.RX_DATA
unnamed: L3.2, U4.TX_DATA
unnamed: LED1.A, R5.2
unnamed: LED2.A, R6.2
unnamed: Q2.B, R8.2
unnamed: C1.1, U7.20 (AREF)
unnamed: C14.1, U5.4 (BP)
unnamed: R1.2, U7.7 (PB6(XTAL1/TOSC1)), Y1.1
RESET: D1.A, J2.5, R2.1, S1.3, S1.4, U7.29 (PC6(/RESET))
RFGND: U4.ANTENNA_GND1, U4.ANTENNA_GND2, X1.2, X1.3 (2), X1.4 (2), X1.5 (2)
RX-AUDIO: C5.1, L5.1
RXD: J3.1, U7.30 (PD0(RXD))
SCK: J2.3, R6.1, U7.17 (PB5(SCK))
SCL: J4.4, R3.1, U7.28 (PC5(ADC5/SCL)), U8.4 (SCK/SCL)
SDA: J4.3, R4.1, U7.27 (PC4(ADC4/SDA)), U8.3 (SDI/SDA)
TX-AUDIO: C3.2, R13.1
TXD: J3.2, U7.31 (PD1(TXD))
V+: C7.1, D3.C, R16.2, U3.3 (IN)
VCC: L7.1, U4.VCC
XCEIVER-RX: L3.1, U7.13 (PB1(OC1A))
XCEIVER-TX: L6.1, U7.14 (PB2(SS/OC1B))

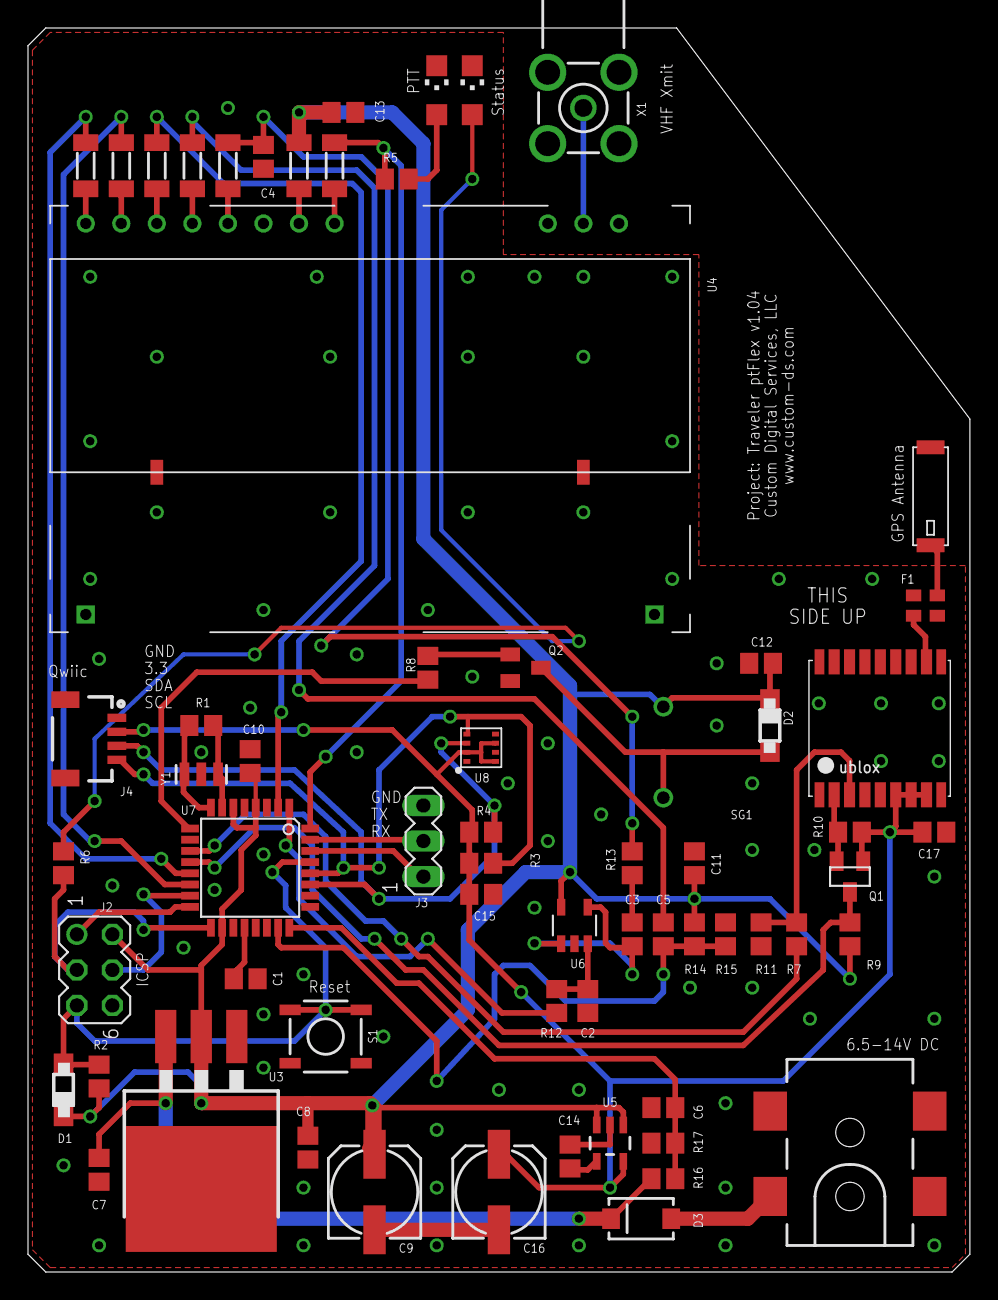
[picture p32: board ptFlex.brd from above]

Board: 2 copper layers, 67.3 x 88.9 mm, 65 parts (0 on the bottom side), 49 nets.
