custom-ds/ptFlex/firmware/ptFlex/ptFlex.ino

/*
Project: Traveler pfFlex Firmware
Copyright 2011-2026 - Zack Clobes (W0ZC), Custom Digital Services, LLC


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
You should have received a copy of the GNU General Public License along with this program.  If not, see <http://www.gnu.org/licenses/>.


Before programming for the first time, the ATmega fuses must be set.
 Low:      0xDF
 High:     0xD6
 Extended: 0xFD
 
*/


#define FIRMWARE_VERSION "1.6.2"
#define CONFIG_PROMPT "\n\n# "
#include "BoardDef.h"   //defines if this is a ptFlex or ptSolar PCB board


#define __PROG_TYPES_COMPAT__
#include <avr/pgmspace.h>
#include <avr/wdt.h>

#include "ptConfig.h"
#include "Modem.h"
#include "GPS.h"
#include "ptTracker.h"

#include "SparkFunBME280.h"
#include <Wire.h>

//PD0 is Serial Port RX
//PD1 is Serial Port TX
#define PIN_PTT_OUT 2     //PD2
#define PIN_AUDIO_OUT 3   //PD3   - APRS Packet Audio
#define PIN_DRA_EN 4      //PD4
#define PIN_AUDIO 5       //PD5   - Audio Annunciation
#define PIN_GPS_EN 6      //PD6
#define PIN_GPS_TX 7      //PD7

#define PIN_GPS_RX 8      //PB0
#define PIN_DRA_TX 9      //PB1
#define PIN_DRA_RX 10     //PB2
//PB3 is MOSI
//PB4 is MISO
#define PIN_LED 13        //PB5

//Analog Pins
#define PIN_AUDIO_IN A0   //PC0
#define PIN_ANALOG_BATTERY A1   //PC1
//PC2 is not used
//PC3 is not used
//PC4 is SDA
//PC5 is SCL
//PC6 is reset and not available


#define DELAY_MS_BETWEEN_XMITS 1250   //How many MS to delay between subsequent packets (as in between GPGGA and GPRMC strings
#define INVALID_GPS_DELAY 50000    //Max additional ms to wait for a GPS fix before transmitting anyway
#define METERS_TO_FEET 3.2808399

//Debugging options
#define XMIT_MILLIS true
#define WATCHDOG


ptConfig Config;                                                                        //Configuration object
ptTracker Tracker(PIN_LED, PIN_AUDIO, PIN_ANALOG_BATTERY, Config.getAnnounceMode());    //Object that manages the board-specific functions
GPS GPSParser(PIN_GPS_RX, PIN_GPS_TX, PIN_GPS_EN);                                      //Object that parses the GPS strings
Modem Aprs(PIN_DRA_EN, PIN_PTT_OUT, PIN_AUDIO_OUT, PIN_DRA_TX, PIN_DRA_RX);;            //Object that assembles the packets for the TNC and transmits them

BME280 Pressure;      //BMP280 pressure/temp sensor

bool bHasBurst;
float fMaxAlt;
float fMaxSpeed;


/**
 * @brief  The function that runs first before the main loop() function is called indefinitely.
 * @note   This function is called once at startup and is used to initialize the board and set up the hardware.
 */
void setup() {
  Serial.begin(19200);

  wdt_disable();    //disable the watchdog timer by default
  #ifdef WATCHDOG
    wdt_enable(WDTO_8S);    //Enable the Watchdog if configured
  #endif

  wdt_reset();    //reset the watchdog timer (even if we're not using it)
  showVersion();    //show the version of the firmware that we're running


  //Init some variables
  fMaxAlt = 0;
  fMaxSpeed = 0;
  bHasBurst = false;

  Tracker.annunciate('k');

  //Additional configurations for the APRS Modem
  Aprs.setDebugLevel(1);
  Aprs.setTxDelay(Config.getRadioTxDelay());
  Aprs.setCourtesyTone(Config.getRadioCourtesyTone());

  //init the I2C devices
  if (Config.getI2cBME280() == 1) {
    //we're supposed to initialize the BME280
    Serial.println(F("Init BME280"));
    Pressure.setI2CAddress(0x76);

    //Begin communication over I2C
    if (Pressure.beginI2C() == false) {
      Serial.println(F(" Could NOT init!"));
    }
  } else {
    Serial.println(F("No I2C devices to init"));
  }
  
  GPSParser.setDebugNEMA(true);    ///TODO: Need to pull this from Configuration
  GPSParser.setDebugLevel(1);    //Get full verbose output from the GPS
}


/**
 * @brief  Main loop for the program.  This is where the main logic of the program is executed.
 * @note   This function will run continuously until the board is powered off or reset.
 */
void loop() {

  float fCurrentAlt, fSpeed;
  unsigned long battMillivolts;
  bool bXmit;             //Flag to indicate whether or not we should transmit this time around
  bool bXmitPermitted;    //Flag that can be set to false to prevent transmission, such as when we're in a country that doesn't allow APRS
  bool bISSPath;          //Flag to see if we should set the APRS Path to transmit up to the ISS
  int iSeconds;
  unsigned long msDelay;    //calculate the number of milliseconds to delay
  byte byTemp;
  char szFreq[9];    //The frequency to transmit on


  wdt_reset();
  
  //Check to see if we have a command from the serial port to indicate that we need to enter config mode
  if (Serial.available()) {
    byTemp = Serial.read();
    if (byTemp == '!') {
      doConfigMode();
    }
  }

  //Reboot the system hourly if configured to do so
  if (Config.getRebootHourly()) {
    //Reboot if we've been running for 60 minutes
    if (millis() > 3600000) {
      //we've been running for 60 minutes - reboot the system
      Serial.println(F("60min Reboot"));
      delay(1000);
      Tracker.reboot();
    }
  }

  battMillivolts = (unsigned long)(Tracker.readBatteryVoltage(true) * 1000);  //read the battery voltage and spit it out to the serial port

  //check to see if we have sufficient battery to run the GPS
  if (battMillivolts >= Config.getVoltThreshGPS()) {
    GPSParser.enableGPS(true);    //enable the GPS module if it's not already. If it wasn't enabled, this will also initialize it.

    GPSParser.collectGPSStrings();
    fCurrentAlt = GPSParser.Altitude();        //get the current altitude
    if (fCurrentAlt > fMaxAlt) {
      fMaxAlt = fCurrentAlt;
    } else {
      if (fMaxAlt > 10000 && (fCurrentAlt < (fMaxAlt - 250))) {
        //Check for burst.  The Burst must be at least 10,000m MSL.
        // To sense a burst, the controller must have fallen at least 250m from the max altitude
  
        bHasBurst = true;
      }
    }
  } else {
    //See if the Battery has dropped 100mV below the threshold.  If so, disable the GPS until the battery comes back up
    if (battMillivolts < (Config.getVoltThreshGPS() - 100)) {
      //we don't have enough battery to run the GPS - disable it
      Serial.println(F("Disabling GPS"));
      GPSParser.disableGPS();
    }
    Serial.println(F("Low Batt, no GPS"));
    delay(750);   //wait for about the amount of time that we'd normally spend grabbing a GPS reading
  }

  bXmit = false;    //assume that we won't transmit this time around

  //Figure out how long to delay before the next packet
  switch (Config.getBeaconType()) {
  case 0:
    //This is no logic to beacon intervals - just plan old time delays
    msDelay = (unsigned long)Config.getBeaconSimpleDelay() * 1000;    //cast this to unsigned long
    if (!GPSParser.FixValid()) {
      Tracker.debugMessage(ptTracker::DEBUG_GPS_INVALID_LOCK);
      msDelay += INVALID_GPS_DELAY;
    }

    if ((millis() - Aprs.getLastTransmitMillis()) > msDelay) {
      //we've waited long enough - transmit
      bXmit = true;
    }

    break;
  case 1:
    //This is for Speed-based beaconing

    if (GPSParser.FixValid()) {
      fSpeed = GPSParser.Knots();        //get the current speed
      if (fSpeed > fMaxSpeed) fMaxSpeed = fSpeed;

      if (fMaxSpeed < Config.getBeaconSpeedThreshLow()) {
        //we're in the slow range
        msDelay = (unsigned long)Config.getBeaconSpeedDelayLow() * 1000;    //cast this to unsigned long

        if ((millis() - Aprs.getLastTransmitMillis()) > msDelay) {
          //we've waited long enough for this speed - transmit
          bXmit = true;
        }
      }

      if (fSpeed >= Config.getBeaconSpeedThreshLow() && fSpeed < Config.getBeaconSpeedThreshHigh()) {
        //we're in the medium range
        msDelay = (unsigned long)Config.getBeaconSpeedDelayMid() * 1000;    //cast this to unsigned long

        if ((millis() - Aprs.getLastTransmitMillis()) > msDelay) {
          //we've waited long enough for this speed - transmit
          bXmit = true;
        }
      }

      if (fSpeed >= Config.getBeaconSpeedThreshHigh()) {
        //we're in the fast range
        msDelay = (unsigned long)Config.getBeaconSpeedDelayHigh() * 1000;    //cast this to unsigned long

        if ((millis() - Aprs.getLastTransmitMillis()) > msDelay) {
          //we've waited long enough for this speed - transmit
          bXmit = true;
        }
      }
    } else {
      //No GPS fix - use the high speed delay + GPS fix timeout before transmitting anyway
      Tracker.debugMessage(ptTracker::DEBUG_GPS_INVALID_LOCK);

      msDelay = (unsigned long)Config.getBeaconSpeedDelayHigh() * 1000;
      if ((millis() - Aprs.getLastTransmitMillis()) > (msDelay + INVALID_GPS_DELAY)) {
        Tracker.debugMessage(ptTracker::DEBUG_DELAY_XMIT_CONTINUE);
        bXmit = true;
      }
    }

    break;
  case 2:
    //This is for Altitude-based beaconing

    if (GPSParser.FixValid()) {
      if (fCurrentAlt < Config.getBeaconAltitudeThreshLow()) {
        //we're in the low phase of the flight - we'll typically send packets more frequently close to the ground
        msDelay = (unsigned long)Config.getBeaconAltitudeDelayLow() * 1000;    //cast this to unsigned long

        if ((millis() - Aprs.getLastTransmitMillis()) > msDelay) {
          //we've waited long enough for this speed - transmit
          bXmit = true;
        }
      }
      if (fCurrentAlt >= Config.getBeaconAltitudeThreshLow() && fCurrentAlt < Config.getBeaconAltitudeThreshHigh()) {
        //we're in the mid-phase of the flight.  We'll transmit regularly in here
        msDelay = (unsigned long)Config.getBeaconAltitudeDelayMid() * 1000;    //cast this to unsigned long

        if ((millis() - Aprs.getLastTransmitMillis()) > msDelay) {
          //we've waited long enough for this speed - transmit
          bXmit = true;
        }
      }
      if (fCurrentAlt >= Config.getBeaconAltitudeThreshHigh()) {
        //we're in the top-phase of the flight.  Transmit more frequenly to get better burst resolution?
        msDelay = (unsigned long)Config.getBeaconAltitudeDelayHigh() * 1000;    //cast this to unsigned long

        if ((millis() - Aprs.getLastTransmitMillis()) > msDelay) {
          //we've waited long enough for this speed - transmit
          bXmit = true;
        }
      }
    } else {
      //No GPS fix - use the low altitude delay + GPS fix timeout before transmitting anyway
      Tracker.debugMessage(ptTracker::DEBUG_GPS_INVALID_LOCK);

      msDelay = (unsigned long)Config.getBeaconAltitudeDelayLow() * 1000;
      if ((millis() - Aprs.getLastTransmitMillis()) > (msDelay + INVALID_GPS_DELAY)) {
        Tracker.debugMessage(ptTracker::DEBUG_DELAY_XMIT_CONTINUE);
        bXmit = true;
      }
    }

    break;
  case 3:
    //Use Time Slotting to determine when to transmit
    iSeconds = GPSParser.getGPSSeconds();

    if (iSeconds == Config.getBeaconSlot1() || iSeconds == (Config.getBeaconSlot1() + 1) || iSeconds == Config.getBeaconSlot2() || iSeconds == (Config.getBeaconSlot2() + 1)) {
      if (Config.getDelayXmitUntilGPSFix()) {
        if (GPSParser.FixValid()) {
          bXmit = true;   //have a valid fix, and it's in our slot. Just transmit
        } else {
          //See if we've haven't transmitted within the INVALID_GPS_DELAY time window.  If we haven't, then transmit anyway
          if ((millis() - Aprs.getLastTransmitMillis()) > INVALID_GPS_DELAY) {
            Tracker.debugMessage(ptTracker::DEBUG_DELAY_XMIT_CONTINUE);
            bXmit = true;
          } else {
            Tracker.debugMessage(ptTracker::DEBUG_DELAY_XMIT);
          }
        }
      } else {
        bXmit = true;   //we don't care about the GPS fix, and it's in our slot. Just transmit
      }
    }

    break;
  case 4:
    //This is a voltage-checked time delay.  It will wait X seconds, but then also wait for the system (solar) voltage to be above a threshold before transmitting
    msDelay = (unsigned long)Config.getMinTimeBetweenXmits() * 1000;    //cast this to unsigned long
    
    if ((millis() - Aprs.getLastTransmitMillis()) > msDelay) {
      //we've waited long enough - see if we have the power to transmit
      if (battMillivolts > Config.getVoltThreshXmit()) {
        
        //We have power to transmit, see if we have a valid GPS fix
        if (GPSParser.FixValid()) {
          //we have a valid GPS fix - transmit
          bXmit = true;
        } else {
          //we don't have a valid GPS fix - Allow up to msDelay + 60s to wait for a fix

          if (Config.getDelayXmitUntilGPSFix()) {
            Tracker.debugMessage(ptTracker::DEBUG_GPS_INVALID_LOCK);
            if ((millis() - Aprs.getLastTransmitMillis()) > (msDelay + INVALID_GPS_DELAY)) {
              //we've waited long enough for a fix - transmit anyway
              Tracker.debugMessage(ptTracker::DEBUG_DELAY_XMIT_CONTINUE);
              bXmit = true;
            } else {
              Tracker.debugMessage(ptTracker::DEBUG_DELAY_XMIT);
            }
          } else {
            bXmit = true;    //we have a valid GPS fix - transmit
          }
        }
      } else {
        Serial.println("Low Batt - no xmit");
      }
    }

    break;    
  }

  
  if (bXmit) {
    bXmitPermitted = true;    //assume that we can transmit
    bISSPath = false;    //assume that we're not using the ISS path

    //Determine the transmit/receive frequency to use
    if (Config.getUseGlobalFreq()) {
      //Look up the current APRS frequency from the GPS Position
      bXmitPermitted = GPSParser.getAPRSFrequency(szFreq);
      Aprs.setTxFrequency(szFreq);    //set the frequency to transmit on
      Aprs.setRxFrequency(szFreq);    //set the frequency to receive on

      //if we're on 145.8250 MHz, then we should use the ISS path
      if (szFreq[2] == '5' && szFreq[4] == '8' && szFreq[5] == '2' && szFreq[6] == '5') {
        //we're on the ISS frequency - use the ISS path
        bISSPath = true;
      }
    } else {
      //we're supposed to use the local frequency - set it up
      Aprs.setTxFrequency(Config.getRadioFreqTx());    //set the frequency to transmit on
      Aprs.setRxFrequency(Config.getRadioFreqRx());    //set the frequency to receive on
    }

    //we're supposed to transmit now
    if (bXmitPermitted) {
      wdt_reset();  

      if (Config.getDisableGPSDuringXmit()) {
        //Disable the GPS to save power
        GPSParser.disableGPS();     //disable the GPS module before transmitting
      }

      sendPositionSingleLine(bISSPath);
    } else {
      Aprs.setLastTransmitMillis();   //reset the last transmit time so that we don't try to transmit again immediately.
      Serial.println(F("Xmit Prohibit"));
    }

    fMaxSpeed = 0;    //reset the max speed to check again this next cycle (Used for Speed-based smart beaconing)
    delay(DELAY_MS_BETWEEN_XMITS);    //delay about a second - if you don't you can run into multiple packets inside of a 2 second window

    if (!GPSParser.FixQuality() || GPSParser.NumSats() < 4) {
      //we are having GPS fix issues - issue an annunciation
      Tracker.annunciate('l');
    }
  }
}


/**
 * @brief sendPositionSingleLine - This function sends the position of the tracker in a single line format. It includes information such as GPS time, latitude, longitude, course, speed, altitude, and other telemetry data.
 * @param bISSPath A boolean indicating whether or not to use the alternate path for communicating via the ISS space station.
 * @return void
 */
void sendPositionSingleLine(bool bISSPath) {
  char szTemp[15];    //largest string held should be the longitude
  int i;
  double insideTemp;    //inside air temp
  
  double airPressure;    //millibars
  float fTemp;    //temporary variable

  char statusIAT = 0;
  
  if (Config.getI2cBME280()) {
    if (Config.getStatusXmitPressure() || Config.getStatusXmitTemp()) {
      //we're supposed to transmit the air pressure and/or temp - go ahead and pre-fetch it
      airPressure = (double)Pressure.readFloatPressure();
      airPressure = airPressure / 100;    //convert back to simple airpressure in hPa
      insideTemp = (double)Pressure.readTempC();
    }
  }

  if (bISSPath) {
    //we're supposed to use the ISS path
    Aprs.packetHeader(Config.getDestination(), Config.getDestinationSSID(), Config.getCallsign(), Config.getCallsignSSID(), "ARISS ", '0', "      ", '0', true);
  } else {
    //we're supposed to use the normal path
    Aprs.packetHeader(Config.getDestination(), Config.getDestinationSSID(), Config.getCallsign(), Config.getCallsignSSID(), Config.getPath1(), Config.getPath1SSID(), Config.getPath2(), Config.getPath2SSID(), (GPSParser.Altitude() < Config.getDisablePathAboveAltitude()));
  }
  
  //      /155146h3842.00N/09655.55WO301/017/A=058239
  uint8_t hh = 0, mm = 0, ss = 0;
  GPSParser.getGPSTime(&hh, &mm, &ss);
  Aprs.packetAppend((char *)"/");

  sprintf(szTemp, "%02d", hh);
  Aprs.packetAppend(szTemp);
  sprintf(szTemp, "%02d", mm);
  Aprs.packetAppend(szTemp);
  sprintf(szTemp, "%02d", ss);
  Aprs.packetAppend(szTemp);

  Aprs.packetAppend((char *)"h");
  //Latitude
  GPSParser.getLatitude(szTemp);
  i=0;

  while (i<7 && szTemp[i]) {
    Aprs.packetAppend(szTemp[i]);
    i++;
  }
  Aprs.packetAppend(GPSParser.LatitudeHemi());
  Aprs.packetAppend(Config.getSymbolPage());

  //Longitude
  GPSParser.getLongitude(szTemp);
  i=0;
  while (i<8 && szTemp[i]) {
    Aprs.packetAppend(szTemp[i]);
    i++;
  }

  Aprs.packetAppend(GPSParser.LongitudeHemi());
  Aprs.packetAppend(Config.getSymbol());

  //Course
  fTemp = GPSParser.Course();

  sprintf(szTemp, "%03d", (int)fTemp);
  Aprs.packetAppend(szTemp);
  Aprs.packetAppend('/');

  //Speed in knots
  fTemp = GPSParser.Knots();
  sprintf(szTemp, "%03d", (int)fTemp);
  Aprs.packetAppend(szTemp);

  Aprs.packetAppend((char *)"/A=");
  //Altitude in Feet
  fTemp = GPSParser.AltitudeInFeet();
  Aprs.packetAppend((long)fTemp, true);

  if (Config.getStatusXmitGPSFix()) {
    //Fix quality and num sats

    if (GPSParser.FixQuality() >= 1 && GPSParser.FixQuality() <=3) {
      //we have a GPS, DGPS, or PPS fix
      Aprs.packetAppend((char *)" 3D");
    } else {
      Aprs.packetAppend((char *)" na");
    }
    sprintf(szTemp, "%d", GPSParser.NumSats());
    Aprs.packetAppend(szTemp);
  }

  if (Config.getStatusXmitBatteryVoltage()) {

    Aprs.packetAppend((char *)" V=");
    Aprs.packetAppend(Tracker.readBatteryVoltage(false));
  }

  if (Config.getI2cBME280() && Config.getStatusXmitTemp()) {
    Aprs.packetAppend((char *)" IAT=");
    Aprs.packetAppend((float)insideTemp);
  }

  if (Config.getI2cBME280() && Config.getStatusXmitPressure()) {
    Aprs.packetAppend((char *)" Press=");
    Aprs.packetAppend((float)airPressure);
  }

  if (Config.getStatusXmitSeconds()) {
    Aprs.packetAppend((char *)" S=");
    Aprs.packetAppend((long)(millis() / 1000), false);
  }

  if (Config.getStatusXmitBurstAltitude() && bHasBurst) {
    Aprs.packetAppend((char *)" Burst=");
    fTemp = fMaxAlt * METERS_TO_FEET;
    Aprs.packetAppend((long)fTemp, true);
  }
 
  Aprs.packetAppend(' ');
  Aprs.packetAppend(Config.getStatusMessage());
  Tracker.readBatteryVoltage(true);  //read the battery voltage before the transmission
  Aprs.packetSend();

  //Normally seeing about 280mV of drop during the transmission with a 0.5F supercap - Correction: seeing about 800mV with .5F as of 5/16/2025
  Tracker.readBatteryVoltage(true);  //read the battery voltage after the transmission
}


/**
 * @brief showVersion - Displays the version of the firmware and configuration
 * @return void
 */
void showVersion() {
  Serial.println(F("ptFlex Tracker"));
  Serial.print(F("Firmware Version: "));
  Serial.println((char *)FIRMWARE_VERSION);
  Serial.print(F("Config Version: "));
  Serial.println(CONFIG_VERSION);
  Serial.flush();
}


/**
 * @brief doConfigMode - This function is used to enter the configuration mode of the tracker. There are diagnostic routines, and the ability to read/write the EEPROM settings.
 * @return void
 */
void doConfigMode()
{
  byte byTemp;

  showVersion();
  Serial.print(CONFIG_PROMPT);

  delay(750);
  Tracker.annunciate('c');

  // keep track of how long we can listen to the GPS
  unsigned long ulUntil = millis() + 600000;

  while (millis() < ulUntil)
  {
    // Endless loop. Only exit is to reboot with the 'Q', or after 10 minutes of inactivity
    wdt_reset();
    if (Serial.available())
    {
      byTemp = Serial.read();

      if (byTemp == '!')
      {
        showVersion();
      }

      if (byTemp == '0')
      {
        // used to reset the tracker back to N0CALL defaults
        Serial.println(F("Clear config"));
        Config.setDefaultConfig();
        Tracker.annunciate('w');
      }

      if (byTemp == 'E' || byTemp == 'e')
      {
        // exercise mode to check out all of the I/O ports

        Serial.println(F("Exercise"));

        Serial.println(F(" annun"));
        Config.setAnnounceMode(0x03); // temporarily set the announce mode to both
        Tracker.annunciate('x');

        Serial.println(Tracker.readBatteryVoltage(true));
        GPSParser.collectGPSStrings(); // check the GPS

        double insideTemp;  // inside air temp
        double airPressure; // millibars
        char status;

        airPressure = (double)Pressure.readFloatPressure();
        airPressure = airPressure / 100; // convert back to simple airpressure in hPa
        insideTemp = (double)Pressure.readTempC();
        // insideTemp = insideTemp / 100;    //convert back to decimal

        if (Config.getI2cBME280())
        {
          Serial.print(F("IAT: "));
          Serial.println(insideTemp);
          Serial.print(F("Press: "));
          Serial.println(airPressure);
        }
      }

      if (byTemp == 't' || byTemp == 'T')
      {
        // Do a long test of the transmitter (useful for spectrum analysis or burn-in testing)

        Aprs.setTxFrequency(Config.getRadioFreqTx()); // set the frequency to transmit on
        Aprs.setRxFrequency(Config.getRadioFreqRx()); // set the frequency to receive on
        Aprs.setTxDelay(Config.getRadioTxDelay());

        Tracker.annunciate('t');

        Aprs.PTT(true); // configures the SA818 as part of the transmit process.
        uint8_t seconds = 5;
        if (byTemp == 'T')
          seconds = 30; // long test

        // Set to plenty of time so that the analyzer can get a fine reading on it
        for (uint8_t i = 0; i < seconds; i++)
        {
          Serial.print(F("."));
          delay(1000);
          wdt_reset();
        }
        Serial.println("");

        Aprs.PTT(false);
      }

      if (byTemp == 'P' || byTemp == 'p')
      {
        // Send a test packet
        Serial.println(F("Test Packet"));
        Aprs.setTxFrequency(Config.getRadioFreqTx()); // set the frequency to transmit on
        Aprs.setRxFrequency(Config.getRadioFreqRx()); // set the frequency to receive on
        Aprs.setTxDelay(Config.getRadioTxDelay());

        if (byTemp == 'p')
        {
          // Just send an APRS Packet
          Aprs.packetHeader(Config.getDestination(), Config.getDestinationSSID(), Config.getCallsign(), Config.getCallsignSSID(), Config.getPath1(), Config.getPath1SSID(), Config.getPath2(), Config.getPath2SSID(), (GPSParser.Altitude() < Config.getDisablePathAboveAltitude()));
          Aprs.packetAppend((char *)">Project Traveler Test");
          Tracker.readBatteryVoltage(true); // read the battery voltage before the transmission
          Aprs.packetSend();
          Tracker.readBatteryVoltage(true); // read the battery voltage after the transmission
        }
        else
        {
          // 'P' - send a diagnostic string
          Aprs.sendTestDiagnotics();
        }
      }

      if (byTemp == 'Q' || byTemp == 'q')
      {
        // Quit the config mode
        reboot();
      }

      if (byTemp == 'R' || byTemp == 'r')
      {
        Config.readEEPROM(); // pull the configs from eeprom
        Config.sendConfigToPC();

        reboot(); // reboot the system while we're waiting for a new config to be loaded
      }

      if (byTemp == 'W' || byTemp == 'w')
      {
        // take the incoming configs and load them into the Config UDT

        Serial.println(F("Config mode...")); // NOTE: This wording is critical for the ptConfigurator to know that we're in config mode

        if (Config.getConfigFromPC())
        {
          Serial.println(F(" loaded"));

          Config.writeEEPROM();
          Serial.println(F(" saved"));

          Tracker.annunciate('w');
        }
        else
        {
          // something failed during the read of the config data
          Serial.println(F(" failed"));
        }

        reboot(); // reboot the system to apply the new configuration
      }

      Serial.println("");
      Serial.print(CONFIG_PROMPT);
      ulUntil = millis() + 600000; // reset the timer for the config mode
    }
  }

  reboot(); // reboot the system if we get here - this is the only way out of the endless loop
}

/**
 * @brief reboot - This function reboots the system by resetting the ATmega328P microcontroller.
 * @return void
 */
void reboot() {
  //Reboot the system
  Serial.println(F("Rebooting..."));
  delay(1000);
  Tracker.reboot();
}

//------------------------------------------ Functions and Timers  for the internal modulation ------------------------------------------
/**
 * @brief ISR - This is the interrupt service routine for the timer.  It is used to generate the audio tones for the VHF transmitter using the AX.25 protocol.
 */
ISR(TIMER1_COMPA_vect) {
  static uint8_t iStuffZero = 0;
  static bool bStuffBit = false;
  static uint16_t iRateGen = 1;
  static uint16_t iTonePhase = 0;      //two byte variable.  The highByte contains the element in arySine that should be output'ed
  static uint8_t toneHigh = 0;

  // digitalWrite(PIN_LED, HIGH);   //Uncomment for troubleshooting ISR Timing


  //increment the phase counter.  It will overflow automatically at > 65535
  switch (toneHigh) {
    case 0:
      iTonePhase += Modem::TONE_LOW_STEPS_PER_TICK; 
      break;
    case 1:
      iTonePhase += Modem::TONE_HIGH_STEPS_PER_TICK;
      break;
    case 2:
      iTonePhase += Modem::TONE_COURTESY_STEPS_PER_TICK;    //courtesy chirp
      break;
    default:
      iTonePhase = Modem::TONE_LOW_STEPS_PER_TICK; 
      break;
  }
  
  OCR2B = Aprs.getDACValue(highByte(iTonePhase));   //analogWrite to PIN PD3, directly using the OCR register

  iRateGen--;
  if (iRateGen == 0) {
    //it's time for the next bit

    if (bStuffBit) {
      //we hit the stuffing counter  - we don't need to get the next bit yet, just change the tone and send one bit
      toneHigh = !toneHigh;
      iStuffZero = 0;

      bStuffBit = false;    //reset this so we don't keep stuffing
      iRateGen = Modem::BAUD_GENERATOR_COUNT;  
    } else {
      //this is just a normal bit - grab the next bit from the szString

      switch(Aprs.getNextBit()) {
        case 0:
          //we only flip the output state if we have a zero
          toneHigh = !toneHigh;   //Flip Bit
          iStuffZero = 0;
          iRateGen = Modem::BAUD_GENERATOR_COUNT;  
          break;     
        case 1:
          //it's a 1, so send the same tone...
          iStuffZero++;      //increament the stuffing counter

          //if there's been 5 in a row, then we need to stuff an extra bit in, and change the tone for that one
          if (iStuffZero == 5 && !Aprs.noBitStuffing()) {
            bStuffBit = true;      //once we hit five, we let this fifth (sixth?) one go, then we set a flag to flip the tone and send a bogus extra bit next time
          }
          iRateGen = Modem::BAUD_GENERATOR_COUNT;  
          break;
        case 2:
          //this is a special case - we need to send a courtesy tone, so set the flag and break out of the loop
          toneHigh = 2;
          bStuffBit = false;
          iRateGen = Modem::COURTESY_TONE_COUNT;  
          break;
      } 
    }
    
  }
  //digitalWrite(PIN_LED, LOW);   //Uncomment for troubleshooting ISR Timing
}
