custom-ds/ptFlex/firmware/ptFlex/GPS.cpp

/*
GPS Data Parser for Project: Traveler Flight Controllers
Copywrite 2011-2026 - Zack Clobes (W0ZC), Custom Digital Services, LLC

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
You should have received a copy of the GNU General Public License along with this program.  If not, see <http://www.gnu.org/licenses/>.

Version History:
Version 2.2.1 - April 11, 2026 - Fixed issue with Korean RF blackout.
Version 2.2.0 - January 26, 2026 - Functionality added to support WSPR mode.
                  * Added function to calculate Maidenhead grid square from latitude and longitude. 
				  * Changed time to uint8_t, and set 99 as invalid. 
				  * Added iLatitude/iLongitudeMicroDeg functions to get lat/lon in microdegrees.
				  * Reworked forbidden transmit zones.
Version 2.1.1 - September 25, 2025 - Removed UK from the prohibited transmit areas.
Version 2.1.0 - July 12, 2025 - Removed support for older uBlox GPS. Fixed bug where GPS was returning excessive precision. Eliminated validateGPSEntence() function.
Version 2.0.0 - May 9, 2025 - Major rewrite to be more object oriented. Added support for ATGM332 GPS module.
Version 1.0.4 - October 18, 2015 - Found bug where GPS latitude and longitude were exceeding the buffer.  Corrected and cleaned up some old code.
Version 1.0.3 - October 7, 2015 - Eliminated excess Serial.print's.  Cleaned up old comments.
Version 1.0.2 - April 27, 2015 - Added the possibility to capture GNGGA and GNRMC strings (instead of just GP***).
Version 1.0.1 - February 27, 2015 - Added initialization to the private member variables.  Cleaned up some old comments.
Version 1.0.0 - January 15, 2015 - Finalized the basic configuration and licensed GPS under the GPL3 license.


*/

#include "GPS.h"
#include <SoftwareSerial.h>


//Public Methods
GPS::GPS(uint8_t pinGPSRx, uint8_t pinGPSTx, uint8_t pinGPSEnable) {
	//Initializer
	this->_pinGPSRx = pinGPSRx;
	this->_pinGPSTx = pinGPSTx;
	this->_pinGPSEnable = pinGPSEnable;

	//Configure the Enable pin, if there's an enable pin defined as non-zero.
	this->disableGPS();    //disable the GPS module

	//Constructor - initialize the vars
	this->_szTemp[0] = 0;
	this->_iTempPtr = 0;
	this->_bFoundStart = false;
	this->_bRMCComplete = false;
	this->_bGGAComplete = false;  

	strcpy(this->_szLatitude, "1234.5678");
	strcpy(this->_szLongitude, "12345.6789");
	strcpy(this->_szGPSDate, "000000"); 
	this->_currTime.hh =_currTime.mm = _currTime.ss = 0;
	this->_cLatitudeHemi = 'N';
	this->_cLongitudeHemi = 'W';
	this->_iFixQuality = 0;
	this->_bFixValid = false;
	this->_iNumSats = 0;
	this->_fAltitude = 0.0;
	this->_fKnots = 0.0;
	this->_fCourse = 0.0;

	this->_lastDecodedMillis = millis();
	this->_outputNEMA = false;
}


/**
 * @brief  Initializes the GPS module and sets it to high altitude mode.
 * @note   The purpose of this function varies depending on which type of GPS module is being init'ed.
 */
void GPS::initGPS() {
	bool bSuccess = false;

	
	SoftwareSerial* GPS = nullptr;
	GPS = new SoftwareSerial(this->_pinGPSRx, this->_pinGPSTx, false);
	GPS->begin(9600);
	delay(500);

	/*
	// UBlox GPS - set the GPS to high altitude mode (Dynamic Model 6 – Airborne < 1g)
	if (this->_GPSType == 1) {
		if (this->_debugLevel > 0) Serial.println(F("Init UBlox"));


		const byte setdm6[] = {0xB5, 0x62, 0x06, 0x24, 0x24, 0x00, 0xFF, 0xFF, 0x06, 0x03, 0x00, 0x00, 0x00, 0x00, 0x10, 0x27, 0x00, 0x00,
			0x05, 0x00, 0xFA, 0x00, 0xFA, 0x00, 0x64, 0x00, 0x2C, 0x01, 0x00, 0x00, 0x00, 0x00, 0x00, 0x00, 0x00, 0x00,
			0x00, 0x00, 0x00, 0x00, 0x00, 0x00, 0x16, 0xDC };

		byte ackByteID = 0;
		byte ackPacket[10];
		
		
		//calculate a response checksum to verify that the config was sent correct.
		// Construct the expected ACK packet
		ackPacket[0] = 0xB5; // header
		ackPacket[1] = 0x62; // header
		ackPacket[2] = 0x05; // class
		ackPacket[3] = 0x01; // id
		ackPacket[4] = 0x02; // length
		ackPacket[5] = 0x00;
		ackPacket[6] = setdm6[2]; // ACK class
		ackPacket[7] = setdm6[3]; // ACK id
		ackPacket[8] = 0; // CK_A
		ackPacket[9] = 0; // CK_B
		
		// Calculate the checksums
		for (byte i=2; i<8; i++) {
			ackPacket[8] = ackPacket[8] + ackPacket[i];
			ackPacket[9] = ackPacket[9] + ackPacket[8];
		}
		
		//send the config to the GPS
		GPS->flush();
		GPS->write(0xFF);
		delay(500);
		
		for (byte i=0; i<44; i++) {
			GPS->write(setdm6[i]);
		}
		
		//keep track of how long we can listen to the GPS
		unsigned long ulUntil = millis() + 3000;
		
		while (millis() < ulUntil ) {
			// Test for success
			if (ackByteID > 9) return true;    //we had all 9 bytes come back through - valid response!!!
		
			// Make sure data is available to read
			if (GPS->available()) {
				byte c = GPS->read();
			
				// Check that bytes arrive in sequence as per expected ACK packet
				if (c == ackPacket[ackByteID]) {
					ackByteID++;
				} else {
					ackByteID = 0; // Reset and look again, invalid order
				}
			}
		}
	}
	*/

	// ATGM332D GPS - set the GPS to high altitude mode and disable unnecessary NMEA sentences
	if (this->_debugLevel > 0) Serial.println(F("Init ATGM332"));

	if (this->_debugLevel > 0) Serial.println(F("Config GGA/RMC"));
	GPS->println(F("$PCAS03,1,0,0,0,1,0,0,0,0*1E")); // turns on only $GNGGA and $GNRMC (1 sec)
	delay(100);

	if (this->_debugLevel > 1) Serial.println(F("Enable air"));
	GPS->println(F("$PCAS11,5*18")); // Airborne mode on ATM336H-5N GPS??
	delay(100);		
	

	
	
	// Clean up
	GPS->end();	//close the serial port to the GPS so it doens't draw excess current
	delete GPS;
	GPS = nullptr;

	pinMode(this->_pinGPSTx, INPUT);	//set the GPS Tx pin back to input mode so it doesn't draw excess current
	pinMode(this->_pinGPSRx, INPUT);	//set the GPS Rx pin back to input mode so it doesn't draw excess current
}


/**
 * @brief  Enables the GPS and waits for the GPS to collect GPGGA and GPRMC sentences.
 * @note   This function will collect GPS strings from the GPS module and parse them for valid sentences. It will timeout after GPS_MAX_COLLECTION_TIME milliseconds if no data is received.
 */
void GPS::collectGPSStrings() {
	SoftwareSerial* GPS = nullptr;
	GPS = new SoftwareSerial(this->_pinGPSRx, this->_pinGPSTx, false);
	GPS->begin(9600);

	
	//Serial.println("collectGPS");
	this->enableGPS(false);		//Make sure the GPS is enabled before trying to collect data

	this->clearInputBuffer();
	this->clearSentenceFlags();      //clear out the temporary flags to indicate that the new sentences have come in

	//keep track of how long we can listen to the GPS
	unsigned long ulUntil = millis() + GPS_MAX_COLLECTION_TIME;

	while (millis() < ulUntil ) {
		//need to continue looping even if the data isn't coming in.

		//see if there's some new GPS data available
		if (GPS->available()) {
			this->addChar(GPS->read());

			//check the sentence flags to see if both RMC and GGA's have been received in this session
			if (this->gotNewRMC() && this->gotNewGGA()) {
				//we got new GGA and RMC strings - exit out now rather than waiting the whole alloted period.
				break;
			}
		}
	}
	// Clean up
	GPS->end();	//close the serial port to the GPS so it doens't draw excess current
	delete GPS;
	GPS = nullptr;
	
	pinMode(this->_pinGPSTx, INPUT);	//set the GPS Tx pin back to input mode so it doesn't draw excess current
	pinMode(this->_pinGPSRx, INPUT);	//set the GPS Rx pin back to input mode so it doesn't draw excess current	
	return;
}


/**
 * @brief  Disables the GPS module.
 * @note   This function is called when the GPS module is not in use.
 */
void GPS::disableGPS() {

	if (this->_pinGPSEnable) {
		//see if the enable is already in output and low, and if the Tx and Rx pins are already in input mode.  If so, don't do anything.
		if (this->getPinMode(this->_pinGPSEnable) == OUTPUT && digitalRead(this->_pinGPSEnable) == HIGH) {
			//the output is already set to disabled

			//check the Tx and Rx pins to see if they are already in input mode
			if (this->getPinMode(this->_pinGPSTx) == INPUT && this->getPinMode(this->_pinGPSRx) == INPUT) {
				//the Tx and Rx pins are already in input mode - don't do anything

				Serial.println(F("GPS is disabled"));
				return;
			}
		}

		//something wasn't already disabled - disable the GPS module
		Serial.println(F("Disable GPS"));


		pinMode(this->_pinGPSEnable, OUTPUT);
		digitalWrite(this->_pinGPSEnable, HIGH);    //shut the GPS back down (active low)
	}

	pinMode(this->_pinGPSTx, INPUT);	//set the GPS Tx pin back to input mode so it doesn't draw excess current
	pinMode(this->_pinGPSRx, INPUT);	//set the GPS Rx pin back to input mode so it doesn't draw excess current
}


/**
 * @brief  Enables the GPS module and initializes it if necessary.
 * @param  initGPS - A boolean value indicating whether to initialize the GPS module or not after enabling it.
 * @note   This function is called when the GPS module is needed.
 */
void GPS::enableGPS(bool initGPS) {

	if (this->_pinGPSEnable) {
		//see if the Enable pin is already in output and low, and if the Tx and Rx pins are already in input mode.  If so, don't do anything.
		if (this->getPinMode(this->_pinGPSEnable) == OUTPUT && digitalRead(this->_pinGPSEnable) == LOW) {
			//the output is already set to enabled
			//Serial.println(F("GPS is enabled"));
			return;	//don't do anything - no need to init the GPS since it's already been done
		}

		Serial.println(F("Enabling GPS"));
		
		pinMode(this->_pinGPSEnable, OUTPUT);
		digitalWrite(this->_pinGPSEnable, LOW);    //enable the GPS (active low)
	}

	if (initGPS) {
		this->initGPS();    //initialize the GPS module
	}
}


/**
 * @brief  Clears the input buffer for the GPS module.
 * @note   This function is called before beginng the collection process.
 */
void GPS::clearInputBuffer() {
  //need to flush out the old data before importing new, or else you can wind up with odd combinations of old headers and new tails
  this->_szTemp[0] = 0;
  this->_iTempPtr = 0;
  this->_bFoundStart = false;
}


/**
 * @brief  Adds a character to the GPS string buffer.  Once a newline is found, the string is parsed for valid sentences.
 * @param  c - The character to add to the GPS string buffer.
 * @return None
 * @note   This function will add a character to the GPS string buffer and parse it for valid sentences.
 */
void GPS::addChar(char c) {
	//first make sure we still have room in the _szTemp for another char (and null termiation)
	if (_iTempPtr >= (_MAX_SENTENCE_LEN - 2)) {
		//we're full and we apparently didn't find an end of string - throw the szTemp away and lets start over
		this->_szTemp[0] = 0;
		this->_iTempPtr = 0;
		this->_bFoundStart = false;
	}

	if (this->_bFoundStart == false) {
		//we are getting a new character, but we don't have a valid start to a sentence yet - see if this is a $
		
		if (c == '$') {
			//we have a new sentence - start storing it to the temp var
			this->_iTempPtr = 0;
			this->_bFoundStart = true;
			
			this->_szTemp[_iTempPtr++] = c;
			this->_szTemp[_iTempPtr] = 0;			//always make sure our resulting string is null terminated
		}
		//this was a start, so it couldn't have been the finish - just return;
		
		return;
	} else {
		//we were already collecting a valid sentence - lets add it to the array
		
		//first make sure it's not the END of the sentence.
		if ((int)c <= 0x0d) {
			//this was probably a \r or \n, but could be some other sort of invalid (null or Control) char
			
			//look at the first few chars of the array to see if it's RMC or GGA.
			if (_szTemp[1] == 'G' && (this->_szTemp[2] == 'P' || this->_szTemp[2] == 'N') && this->_szTemp[3] == 'R' && this->_szTemp[4] == 'M' && this->_szTemp[5] == 'C') {
				//we have the start of an RMC string

				if (this->_outputNEMA) Serial.println(this->_szTemp);		//dump the GPS sentence to the serial port if desired.
				this->_bRMCComplete = true;    //set a flag indicating that an RMC sentence has been received, therefore we have valid data

				//Serial.println(F("Validating RMC"));
				//this->validateGPSSentence(this->_szTemp, 13, 23);	//validate the GGA sentence to make sure it has the right number of commas and is long enough
				this->parseRMC();

				this->_bGotNewRMC = true;      //set a temporary flag indicating that we got a new RMC sentence
				this->_lastDecodedMillis = millis();    //keep track of the time when we last received a sentence
			
			} else if (_szTemp[1] == 'G' && (this->_szTemp[2] == 'P' || this->_szTemp[2] == 'N') && this->_szTemp[3] == 'G' && this->_szTemp[4] == 'G' && this->_szTemp[5] == 'A') {
				//we have the start of an GGA string
				
				if (this->_outputNEMA) Serial.println(this->_szTemp);		//dump the GPS sentence to the serial port if desired.
				this->_bGGAComplete = true;

				//Serial.println(F("Validating GGA"));
				//this->validateGPSSentence(this->_szTemp, 14, 30);	//validate the GGA sentence to make sure it has the right number of commas and is long enough
				this->parseGGA();

				this->_bGotNewGGA = true;      //set a temporary flag indicating that we got a new RMC sentence
				this->_lastDecodedMillis = millis();    //keep track of the time when we last received a sentence
			}
			
			//even if we didn't find an RMC or GGA string, we still made it to the end - throw out whatever is still in szTemp
			this->_szTemp[0] = 0;
			this->_iTempPtr = 0;
			this->_bFoundStart = false;
			
		} else {
			//this is just a "normal char".  Add it to the array and quit
			this->_szTemp[this->_iTempPtr++] = c;
			this->_szTemp[this->_iTempPtr] = 0;			//always make sure our resulting string is null terminated
			return;
		}
	}
}


/**
 * @brief   Parses apart the GPRMC string and extracts the time, latitude, longitude, speed, and other information.
 * @note    This function is used to parse the RMC string from the GPS module.
 */
void GPS::parseRMC() {
//This function parses the time and altitude from the GGA string that is stored in the variable being passed
//0         10        20        30        40        50        60        70
//01234567890123456789012345678901234567890123456789012345678901234567890
//$GPRMC,224831,A,3805.5827,N,09755.0740,W,000.0,000.0,240806,005.9,E*65

	char sz[10];			//temp var
	char szB[3];			//temp var
	char* ptrTemp;

	//Set the szTemp to a testing string
	// strcpy(this->_szTemp, "$GNRMC,162315.00,A,4630.12340,N,10545.05519,W,0.022,137.11,120624,,,A*7C");
	// strcpy(this->_szTemp, "$GNRMC,220501.00,A,5130.12345,N,00007.54321,W,000.4,090.2,020225,,,A*72");
	// strcpy(this->_szTemp, "$GNRMC,153020.00,A,4045.12345,N,07359.54321,W,003.2,182.5,020225,,,A*7B");
	// strcpy(this->_szTemp, "$GPRMC,123519.00,A,4807.038,N,01131.000,E,022.4,084.4,230394,,,A*6C");

	ptrTemp = &this->_szTemp[7];			//set this pointer to the hours digit
	

	getString(ptrTemp, sz, 7);

	if (sz[0] == '\0') {
		//the time was empty - just return
		this->_currTime.hh = 99;
		this->_currTime.mm = 99;
		this->_currTime.ss = 99;
	} else {
		//we have a time - parse it
		szB[0] = sz[0];
		szB[1] = sz[1];
		szB[2] = 0;
		this->_currTime.hh = atoi(szB);

		szB[0] = sz[2];
		szB[1] = sz[3];	
		this->_currTime.mm = atoi(szB);

		szB[0] = sz[4];
		szB[1] = sz[5];
		this->_currTime.ss = atoi(szB);
	}

	ptrTemp = this->skipToNext(ptrTemp);			//skip thru the rest of the chars in the time

	//see if we have valid fix (A) or invalid (V)
	this->getString(ptrTemp, sz, 2);
	if (sz[0] == 'A') {
		this->_bFixValid = true;
	} else {
		this->_bFixValid = false;
	}
	ptrTemp = this->skipToNext(ptrTemp);


	//get the Latitude
	this->getString(ptrTemp, this->_szLatitude, _MAX_LATITUDE_LEN);
	if (this->_szLatitude[0] == '\0') {
		//the longitude was empty
		strcpy(this->_szLatitude, "0000.0000");
	}
	ptrTemp = this->skipToNext(ptrTemp);

	//get Latitude Hemisphere
	this->getString(ptrTemp, sz, 2);
	if (sz[0] == 'S') {
		this->_cLatitudeHemi = 'S';
	} else {
		this->_cLatitudeHemi = 'N';
	}
	ptrTemp = this->skipToNext(ptrTemp);


	//get the Longitude
	this->getString(ptrTemp, this->_szLongitude, _MAX_LONGITUDE_LEN);
	if (this->_szLongitude[0] == '\0') {
		//the longitude was empty
		strcpy(this->_szLongitude, "00000.0000");
	}
	ptrTemp = this->skipToNext(ptrTemp);

	//get Latitude Hemisphere
	this->getString(ptrTemp, sz, 2);
	if (sz[0] == 'E') {
		this->_cLongitudeHemi = 'E';
	} else {
		this->_cLongitudeHemi = 'W';
	}
	ptrTemp = this->skipToNext(ptrTemp);

	//get speed in knots
	this->getString(ptrTemp, sz, 6);
	this->_fKnots = atof(sz);
	ptrTemp = this->skipToNext(ptrTemp);

	//get course of track
	this->getString(ptrTemp, sz, 6);
	this->_fCourse = atof(sz);
	ptrTemp = this->skipToNext(ptrTemp);	
	
	//get date
	this->getString(ptrTemp, this->_szGPSDate, 7);

	this->convertLatLon();		//convert the lat/lon strings to decimal format


}


/**
 * @brief   Parses apart the GPGGA string and extracts the time, latitude, longitude, altitude, and other information.
 * @note    This function is used to parse the GGA string from the GPS module.
 */
void GPS::parseGGA() {
	//This function parses the time and altitude from the GGA string that is stored in the variable being passed
	//0         10        20        30        40        50        60        70
	//01234567890123456789012345678901234567890123456789012345678901234567890
	//$GPGGA,232440   ,3804.3322 ,N,09756.1222 ,W,6,03,2.7,485.1,M,-26.7,M,,*
	//$GNGGA,162315.00,3805.57830,N,09755.05519,W,1,03,1.86,577.4,M,-26.1,M,,*76
	char sz[10];			//temp var
	char szB[3];			//temp var
	
	char* ptrTemp;

	//Set the szTemp to a testing string
	//strcpy(this->_szTemp, "$GNGGA,162315.00,4630.12340,N,10545.05519,W,1,03,1.86,15577.4,M,-26.1,M,,*76");
	//strcpy(this->_szTemp, "$GNGGA,153025.00,4045.12360,N,07359.54300,W,5,14,0.8,13.00,M,-34.5,M,1.8,0000*43");
	//strcpy(this->_szTemp, "$GPGGA,021430.50,3746.5123,N,12225.1678,W,1,10,0.7,15.2,M,-25.3,M,,*76");
	//strcpy(this->_szTemp, "$GPGGA,184545.00,3345.8762,N,11751.3210,W,2,12,0.8,102.3,M,-33.0,M,0004,0007*6A");

	ptrTemp = &this->_szTemp[7];			//set this pointer to the hours digit

	getString(ptrTemp, sz, 7);

	if (sz[0] == '\0') {
		//the time was empty - just return
		this->_currTime.hh = 99;
		this->_currTime.mm = 99;
		this->_currTime.ss = 99;
	} else {
		//we have a time - parse it
		szB[0] = sz[0];
		szB[1] = sz[1];
		szB[2] = 0;
		this->_currTime.hh = atoi(szB);

		szB[0] = sz[2];
		szB[1] = sz[3];	
		this->_currTime.mm = atoi(szB);

		szB[0] = sz[4];
		szB[1] = sz[5];
		this->_currTime.ss = atoi(szB);
	}

	ptrTemp = this->skipToNext(ptrTemp);			//skip thru the rest of the chars in the time

	//get the Latitude
	getString(ptrTemp, this->_szLatitude, _MAX_LATITUDE_LEN);
	if (this->_szLatitude[0] == '\0') {
		//the longitude was empty
		strcpy(this->_szLatitude, "0000.0000");
	}
	ptrTemp = skipToNext(ptrTemp);

	//get Latitude Hemisphere
	this->getString(ptrTemp, sz, 2);
	if (sz[0] == 'S') {
		this->_cLatitudeHemi = 'S';
	} else {
		this->_cLatitudeHemi = 'N';
	}
	ptrTemp = skipToNext(ptrTemp);


	//get the Longitude
	this->getString(ptrTemp, this->_szLongitude, _MAX_LONGITUDE_LEN);
	if (this->_szLongitude[0] == '\0') {
		//the longitude was empty
		strcpy(_szLongitude, "00000.0000");
	}
	ptrTemp = this->skipToNext(ptrTemp);

	//get Latitude Hemisphere
	this->getString(ptrTemp, sz, 2);
	if (sz[0] == 'E') {
		this->_cLongitudeHemi = 'E';
	} else {
		this->_cLongitudeHemi = 'W';
	}
	ptrTemp = this->skipToNext(ptrTemp);

	//get position fix quality
	this->getString(ptrTemp, sz, 2);
	this->_iFixQuality = atoi(sz);
	ptrTemp = this->skipToNext(ptrTemp);
	
	//get number of sats received
	this->getString(ptrTemp, sz, 3);
	this->_iNumSats = atoi(sz);
	ptrTemp = this->skipToNext(ptrTemp);
	
	ptrTemp = this->skipToNext(ptrTemp);		//skip over horizontal dilution
	
	this->getString(ptrTemp, sz, 8);
	this->_fAltitude = atof(sz);

	this->convertLatLon();		//convert the lat/lon strings to decimal format
}


/**
 * @brief   Extracts a substring from the given string until a comma or null character is found.
 * @param   ptrHaystack: The string to search in.
 * @param   ptrFound: The buffer to store the found substring.
 * @param   iMaxLength: The maximum length of the substring to extract.
 * @return: None.
 * @note    This function is used to extract substrings from GPS sentences.
 */
void GPS::getString(char *ptrHaystack, char *ptrFound, int iMaxLength) {
	
	*ptrFound = '\0';			//be sure that the Found is null terminated even if we didn't find anything
	
	int i = 0;
	while (ptrHaystack[i] != '\0' && ptrHaystack[i] != ',' && i < (iMaxLength - 1)) {
		
		//this is just a char - copy it to the array
		ptrFound[i] = ptrHaystack[i];
		ptrFound[i+1] = '\0';		//null terminate the return		
		
		i++;
	}
}


/**
 * @brief   Skips to the next comma or null character in the string.
 * @param   ptr: A pointer to the current position in the string.
 * @return: A pointer to the next character after the comma or null character.
 * @note    This function is used to skip over characters in a GPS sentence until it reaches a comma or null character.
 */
char* GPS::skipToNext(char *ptr) {
	//takes a pointer, advances through until it either hits a null or gets past the next comma

	while (*ptr != ',' && *ptr != '\0') {
		//just a char - incr to the next one
		ptr++;	
	}
	
	if (*ptr == ',') ptr++;			//if we landed on a comma, advance one
	return ptr;
}


/** 
 * @brief  Returns the current pin mode of the specified pin.
 * @param  pin - The pin number to check the mode of.
 * @return The pin mode of the specified pin (INPUT, OUTPUT, INPUT_PULLUP, or UNKNOWN_PIN).
 */
uint8_t GPS::getPinMode(uint8_t pin) {
	uint8_t bit = digitalPinToBitMask(pin);
	uint8_t port = digitalPinToPort(pin);
  
	// I don't see an option for mega to return this, but whatever...
	if (NOT_A_PIN == port) return UNKNOWN_PIN;
  
	// Is there a bit we can check?
	if (0 == bit) return UNKNOWN_PIN;
  
	// Is there only a single bit set?
	if (bit & bit - 1) return UNKNOWN_PIN;
  
	volatile uint8_t *reg, *out;
	reg = portModeRegister(port);
	out = portOutputRegister(port);
  
	if (*reg & bit)
	  return OUTPUT;
	else if (*out & bit)
	  return INPUT_PULLUP;
	else
	  return INPUT;
  }


/**
 * @brief   Returns the current latitude in the form of a string.
 * @param   sz: A pointer to a char array to store the latitude in.
 * @return: None.
 * @note    The function will return the latitude in the format ddmm.mm, where dd is degrees and mm.mm is minutes.  The string will be null terminated.
 */
void GPS::getLatitude(char *sz) {
  byte i = 0;
  sz[0] = 0x00;   //always make sure we return null if no valid data in the source

  if (this->_bGGAComplete || this->_bRMCComplete) {
    while(this->_szLatitude[i] > 0x00 && i < _MAX_LATITUDE_XMIT_LEN) {
      sz[i] = this->_szLatitude[i];
      i++;
      sz[i] = 0x00;   //always null terminate the end
    }
  }
}


/**
 * @brief   Returns the current longitude in the form of a string.
 * @param   sz: A pointer to a char array to store the longitude in.
 * @return: None.
 * @note    The function will return the latitude in the format dddmm.mm, where ddd is degrees and mm.mm is minutes.  The string will be null terminated.
 */
void GPS::getLongitude(char *sz) {
  byte i = 0;
  sz[0] = 0x00;   //always make sure we return null if no valid data in the source

  if (this->_bGGAComplete || this->_bRMCComplete) {
    while(this->_szLongitude[i] > 0x00 && i < _MAX_LONGITUDE_XMIT_LEN) {
      sz[i] = this->_szLongitude[i];
      i++;
      sz[i] = 0x00;   //always null terminate the end
    }
  }
}

/**
 * @brief   Returns the current altitude in the form of two bytes, with the coarse altitude in the first byte that will be transmitted as "power" and the fine as a signed 8 bit integer.
 * @param   CoarseAltitude: A reference to a byte to store the coarse altitude in.
 * @param   FineAltitude: A reference to a byte to store the fine altitude in. This will be in the value of 0-200, which is then offsets the transmit frequency.
 * @return: None.
 * @note    The coarse altitude is the integer part of the altitude in meters, and the
 */
void GPS::getWSPRAltitude(uint8_t &CoarseAlt, uint8_t &FineAlt) {
	//WSPR altitude is encoded in 2 bytes, with the coarse altitude in the first byte and the fine altitude in the second byte.  The coarse altitude is the integer part of the altitude in meters, and the fine altitude is the fractional part of the altitude in meters multiplied by 100 (to get two decimal places).

	const uint8_t AltLUT[19] = {0, 3, 7, 10, 13, 17, 20, 23, 27, 30, 33, 37, 40, 43, 47, 50, 53, 57, 60};	//Look Up Table for the Coarse altitude, based on the WSPR encoding of 0-60 in the fine altitude byte.
	int iAltitude = (int)this->_fAltitude;    //get the altitude in meters as an integer
	if (_bGGAComplete == false) iAltitude = 0;		//if we don't have a valid GGA sentence, just return 0 for the altitude
	// Clamp to allowed range
	if (iAltitude < 0) iAltitude = 0;
	if (iAltitude > 19000) iAltitude = 19000;

	
	uint8_t tempAlt = iAltitude / 1000;                 // truncates toward 0 in Arduino C++
	if (tempAlt > 18) tempAlt = 18;                   // clamp to max index of LUT
	CoarseAlt = AltLUT[tempAlt];     // get the coarse altitude from the LUT
	FineAlt = (iAltitude % 1000) / 5;            //Least significant byte is encoded as 0-200
}

void GPS::testWSPRAltitude() {
	float Alt;
	uint8_t Coarse, Fine;
	for (Alt = -2000; Alt <= 21000; Alt += 250) {
		this->_fAltitude = Alt;
		this->_bGGAComplete = true;	//set this to true so that the getWSPRAltitude function doesn't just return 0 for the altitude

		this->getWSPRAltitude(Coarse, Fine);
		Serial.print("Alt: ");
		Serial.print(Alt);
		Serial.print(" Coarse: ");
		Serial.print(Coarse);
		Serial.print(" Fine: ");
		Serial.println(Fine);
	}
}


/**
 * @brief   Determines if the current GPS location is in a no-transmit zone.
 * @return: True if in a no-transmit zone, false otherwise.
 * @note    This function checks the current latitude and longitude against known no-transmit zones (Yemen and North Korea).
 */
bool GPS::isRFBlackoutZone() {
	//Determine if we are in a no-transmit zone based on lat/lon
	//Convert the latitude and longitude to an integer for comparison
	// Lat/Lon are in the format ddmm, and range from -9000 to 9000 and -18000 to 18000 respectively
	int iLat = atoi(this->_szLatitude);
	int iLon = atoi(this->_szLongitude);

	if (this->_cLatitudeHemi == 'S') iLat = -iLat;    //convert to negative if we're in the southern hemisphere
	if (this->_cLongitudeHemi == 'W') iLon = -iLon;    //convert to negative if we're in the western hemisphere


	//Check for Yemen
	if (iLat >= 1148 && iLat <= 1912 && iLon >= 4200 && iLon <= 5442) return true;

	//Check for North Korea
	if (iLat >= 3742 && iLat <= 4306 && iLon >= 12400 && iLon <= 13100) return true;

	return false;	//we're not in a blackout zone
}

/**
 * @brief   Returns the appopriate APRS frequency for the current location.  This function is used to determine the frequency to use for APRS transmissions.
 * @param   sz: A pointer to a char array to store the frequency in.
 * @return: None.
 * @note    Attempts to determine the frequency based on lat/lon. If there is no valid GPS position, then the function will return the US frequency of 144.390 MHz.
 *            If the position is over the Yemen or North Korea, a 0.000 MHz frequency is returned indicating that no transmissions should be made.
 */
bool GPS::getAPRSFrequency(char *sz) {
	
	uint8_t freqSelected = 99;	//Default to 99, which is the International Space Station frequency of 145.825 MHz

	if (this->_bFixValid == false) {
		//we don't have a valid fix, so return the default US frequency of 144.3900 MHz
		freqSelected = 1;		// just default to the US Frequency of 144.3900 MHz if we don't have a Sat Lock
	} else {

		//Convert the latitude and longitude to an integer for comparison
		// Lat/Lon are in the format ddmm, and range from -9000 to 9000 and -18000 to 18000 respectively
		int iLat = atoi(this->_szLatitude);
		int iLon = atoi(this->_szLongitude);

		if (this->_cLatitudeHemi == 'S') iLat = -iLat;    //convert to negative if we're in the southern hemisphere
		if (this->_cLongitudeHemi == 'W') iLon = -iLon;    //convert to negative if we're in the western hemisphere


		//Check to see if we're in a no-transmit zone
		if (this->isRFBlackoutZone()) {
			strcpy(sz, "000.0000");
			return false;	//we're in a no-transmit zone
		}

		//The table below is a list of the APRS frequencies for different regions of the world. The ordering must go from least specific, to most specific.
		// Any transmit-prohibited areas must be listed LAST, or else they will be overridden by the other regions.

		//Use the included XLSX file to maintain this list of lat/lons and associated frequencies.

		// Transmit geo-lookups from east specific, to most specific. Transmit prohibits must be at the bottom of this list.
		if (iLat >= 0 && iLat <= 8000 && iLon >= -13000 && iLon <= -3400) freqSelected = 1;    //US Canada Mexico on 144.3900MHz
		if (iLat >= -6000 && iLat <= 0 && iLon >= -10300 && iLon <= -3300) freqSelected = 1;    //South America on 144.3900MHz
		if (iLat >= -1000 && iLat <= 2000 && iLon >= 9600 && iLon <= 14200) freqSelected = 1;    //Indonesia/Malaysia/Singapore on 144.3900MHz
		if (iLat >= 2000 && iLat <= 5200 && iLon >= 6900 && iLon <= 13500) freqSelected = 4;    //China/Taiwan on 144.6400MHz
		if (iLat >= -4900 && iLat <= -3200 && iLon >= 16500 && iLon <= 18000) freqSelected = 3;    //New Zealand on 144.5750MHz
		if (iLat >= -4500 && iLat <= -900 && iLon >= 11100 && iLon <= 15400) freqSelected = 7;    //Austrailia on 145.1750MHz
		if (iLat >= 3600 && iLat <= 7300 && iLon >= -1200 && iLon <= 5000) freqSelected = 6;    //Europe on 144.8000MHz
		if (iLat >= -3600 && iLat <= 3600 && iLon >= -2100 && iLon <= 5200) freqSelected = 6;    //Africa on 144.8000MHz
		if (iLat >= 5200 && iLat <= 7500 && iLon >= 5000 && iLon <= 18000) freqSelected = 6;    //Russia on 144.8000MHz
		if (iLat >= 5000 && iLat <= 8000 && iLon >= -16900 && iLon <= -13000) freqSelected = 1;    //Alaska on 144.3900MHz
		if (iLat >= 1500 && iLat <= 2600 && iLon >= -16500 && iLon <= -15300) freqSelected = 1;    //Hawaii on 144.3900MHz
		if (iLat >= -3000 && iLat <= 300 && iLon >= -7000 && iLon <= -3300) freqSelected = 9;    //Brazil on 145.5700MHz
		if (iLat >= 3000 && iLat <= 4500 && iLon >= 12900 && iLon <= 14600) freqSelected = 5;    //Japan on 144.6600MHz
		if (iLat >= 500 && iLat <= 2036 && iLon >= 9700 && iLon <= 10600) freqSelected = 8;    //Thailand on 145.5300MHz
		if (iLat >= 2200 && iLat <= 2230 && iLon >= 11347 && iLon <= 11430) freqSelected = 2;    //Hong Kong on 144.5250MHz
		if (iLat >= 4900 && iLat <= 6100 && iLon >= -800 && iLon <= 200) freqSelected = 6;    //UK on 144.8000MHz
	}

	switch (freqSelected) {
	case 1:
		//North America, US, Canada, Mexico
		strcpy(sz, "144.3900");
		break;
	case 2:
		//Hong Kong
		strcpy(sz, "144.5250");
		break;
	case 3:	
		//New Zealand
		strcpy(sz, "144.5750");
		break;
	case 4:
		//China/Taiwan
		strcpy(sz, "144.6400");
		break;
	case 5:
		//Japan
		strcpy(sz, "144.6600");
		break;
	case 6:
		//Europe/Africa/Russia
		strcpy(sz, "144.8000");
		break;
	case 7:
		//Australia
		strcpy(sz, "145.1750");
		break;
	case 8:
		//Thailand
		strcpy(sz, "145.5300");
		break;
	case 9:
		//Brazil
		strcpy(sz, "145.5700");
		break;
	case 99:
		//ISS Satellite
		strcpy(sz, "145.8250");
		break;
	default:
		strcpy(sz, "144.3900");
		break;
	}
	
	return true;		//we can transmit
}

/**
 * @brief   Calculates the Maidenhead grid square based on the current latitude and longitude.
 * @param   sz: A pointer to a char array to store the grid square in.
 * @note: Returns a 6-character Maidenhead grid square.
 */
void GPS::getGridSquare(char *sz, uint8_t precision) {
	if (this->_debugLevel > 1) {
		Serial.println("");
		Serial.print(F("GridSq -"));
		Serial.println(precision);
	}

	if (precision != 6) precision = 4;

  // Shift into "positive" coordinate space:
  // lon: [-180..+180] -> [0..360]
  // lat: [ -90.. +90] -> [0..180]
  int32_t lon = this->_iLongitude + 180000000L;
  int32_t lat = this->_iLatitude +  90000000L;

  // ----- Field (A-R) -----
  // lon field size = 20 deg = 20,000,000 uDeg
  // lat field size = 10 deg = 10,000,000 uDeg
  uint8_t fieldLon = lon / 20000000L;
  uint8_t fieldLat = lat / 10000000L;

  lon -= (int32_t)fieldLon * 20000000L;
  lat -= (int32_t)fieldLat * 10000000L;

  sz[0] = 'A' + fieldLon;
  sz[1] = 'A' + fieldLat;

  // ----- Square (0-9) -----
  // lon square size = 2 deg = 2,000,000 uDeg
  // lat square size = 1 deg = 1,000,000 uDeg
  uint8_t squareLon = lon / 2000000L;
  uint8_t squareLat = lat / 1000000L;

  lon -= (int32_t)squareLon * 2000000L;
  lat -= (int32_t)squareLat * 1000000L;

  sz[2] = '0' + squareLon;
  sz[3] = '0' + squareLat;

  if (precision == 4) {
    sz[4] = '\0';

		if (this->_debugLevel > 0) Serial.println(sz);

		return;
  }

  // ----- Subsquare (a-x) -----
  // lon subsquare size = (2 deg / 24) = 0.083333... deg
  // in microdegrees: 2,000,000 / 24 = 83,333 (remainder exists)
  // lat subsquare size = (1 deg / 24) = 0.041666... deg
  // in microdegrees: 1,000,000 / 24 = 41,666 (remainder exists)
  //
  // Use integer division with rounding-safe scaling:
  // subLon = (lon * 24) / 2,000,000
  // subLat = (lat * 24) / 1,000,000

  uint8_t subLon = (uint32_t)lon * 24UL / 2000000UL;  // 0..23
  uint8_t subLat = (uint32_t)lat * 24UL / 1000000UL;  // 0..23

  sz[4] = 'a' + subLon;
  sz[5] = 'a' + subLat;
  sz[6] = '\0';

  if (this->_debugLevel > 0) Serial.println(sz);

}


/*
  Convert "ddmm.mmmm" latitude string to signed microdegrees (deg * 1e6).
  hemi: 'N' or 'S'
  Example: "3745.1234", 'N'  ->  +37752056 (approx)
*/
void GPS::convertLatLon() {

	uint8_t dd;
	uint8_t mm;
	uint16_t frac;
	const char *p;
	uint32_t min_x10000;
	uint32_t add_uDeg;
	uint8_t i;

	if (this->_debugLevel > 1) {
		Serial.println("");
		Serial.print(F("Lat/Lon "));
		Serial.print(this->_szLatitude);
		Serial.print(F(", "));
		Serial.println(this->_szLongitude);	
	}


	if (this->_szLatitude[0] == '\0' || this->_szLongitude[0] == '\0') {
		//we don't have valid lat/lon strings - just return
		this->_iLatitude = 0;
		this->_iLongitude = 0;
		Serial.println(F("! INVLD !"));
		return;
	}

	//Latitude
	// degrees (dd)
  dd = (uint8_t)((this->_szLatitude[0] - '0') * 10 + (this->_szLatitude[1] - '0'));

  // minutes whole part (mm)
  mm = (uint8_t)((this->_szLatitude[2] - '0') * 10 + (this->_szLatitude[3] - '0'));

  // fractional minutes (mmmm), up to 4 digits
  frac = 0;
  p = this->_szLatitude + 5;

  for (i = 0; i < 4; i++) {
    char c = *p;
    if (c >= '0' && c <= '9') { 
		frac = (uint16_t)(frac * 10 + (c - '0')); 
		p++; 
	}
    else { 
		frac = (uint16_t)(frac * 10); 
	} // pad with zeros
  }

  // minutes in 1e-4 minutes
  min_x10000 = (uint32_t)mm * 10000UL + (uint32_t)frac;

  // Convert minutes to microdegrees:
  // microdeg_add = min_x10000 * (1e6 / (60 * 1e4)) = min_x10000 * (5/3)
  // Use rounding: (x*5 + 1) / 3
  add_uDeg = (uint32_t)((min_x10000 * 5UL + 1UL) / 3UL);

  this->_iLatitude = (int32_t)dd * 1000000L + (int32_t)add_uDeg;
  if (this->_cLatitudeHemi == 'S') 
  	this->_iLatitude = -this->_iLatitude;
 
  
  //Longitude
  // degrees (ddd)
  dd = (uint16_t)((this->_szLongitude[0] - '0') * 100 + (this->_szLongitude[1] - '0') * 10 + (this->_szLongitude[2] - '0'));

  // minutes whole part (mm)
  mm = (uint8_t)((this->_szLongitude[3] - '0') * 10 + (this->_szLongitude[4] - '0'));

  // fractional minutes (mmmm), up to 4 digits
  frac = 0;
  p = this->_szLongitude + 6;

  for (i = 0; i < 4; i++) {
    char c = *p;
    if (c >= '0' && c <= '9') { 
		frac = (uint16_t)(frac * 10 + (c - '0')); 
		p++; }
    else { 
		frac = (uint16_t)(frac * 10); 
	} // pad with zeros
  }

  // minutes in 1e-4 minutes
  min_x10000 = (uint32_t)mm * 10000UL + (uint32_t)frac;

  // microdeg_add = min_x10000 * (5/3), rounded
  add_uDeg = (uint32_t)((min_x10000 * 5UL + 1UL) / 3UL);

  this->_iLongitude = (int32_t)dd * 1000000L + (int32_t)add_uDeg;
  if (this->_cLongitudeHemi == 'W') 
  	this->_iLongitude = -this->_iLongitude;

	if (this->_debugLevel > 1) {
		Serial.print(this->_iLatitude);
		Serial.print(F(", "));
		Serial.println(this->_iLongitude);
	}
}
