custom-ds/ptFlex/(commit log)

2025-06-15 Initial transfer of ptSolar to ptFlex starter files.
    [Timer Value Comparisons for Baud and Tone Generation.xlsx, ptFlex.kicad_pcb, ptFlex.kicad_sch, untitled.kicad_pcb]
2025-06-21 Schematic mostly revised for v2.0
    [ptFlex.kicad_pcb, ptFlex.kicad_sch, untitled.kicad_pcb]
2025-06-21 PCB nearing final
    [ptFlex.kicad_pcb, ptFlex.kicad_sch]
2025-06-22 Back filed old versions of PCB from the ptFlex-hardware project into this repo. Shrunk the PCB down by 5mm.
    [ptFlex.brd, ptFlex.kicad_pcb, ptFlex.kicad_sch, ptFlex.sch]
2025-06-22 Swapped out Piezo symbol. Minor tweaks
    [ptFlex.kicad_pcb, ptFlex.kicad_sch]
2025-06-22 Renumbered all parts.
    [ptFlex.kicad_pcb, ptFlex.kicad_sch]
2025-06-24 Finalized version 2.0.0 of the PCB to bring it in sync with the ptSolar design.
    [Bill of Materials.csv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]
2025-07-11 Migrated firmware from ptSolar to ptFlex. Adjusting for new defaults, 16MHz clock speed, and voltage sense divider change.
2025-07-12 Updated to firmware 1.5.0. This includes a few minor fixes, and an update to configuration version PT0101. Backwards support for alternate GPS and transmitters has been removed.
    [GPS.cpp, GPS.h, Modem.cpp, ptConfig.cpp, ptConfig.h, ptFlex.ino]
2025-07-19 Board redesigned to 2.0.1 to fix missing SDA/SCL pins to uC. Shrunk board slightly. Fixed SMA center hole being too small.
    [ptFlex.kicad_pcb, ptFlex.kicad_sch]
2025-07-29 Adjusting voltage divider resistor precision.
    [Bill of Materials.csv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]
2025-08-22 Updating to PCB 2.0.1 to fix missing I2C wires.
    [Bill of Materials.csv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]
2025-09-27 General clean up
    [ptFlex-B_Cu.gbr, ptFlex-B_Mask.gbr, ptFlex-B_Paste.gbr, ptFlex-B_Silkscreen.gbr, ptFlex-Edge_Cuts.gbr, ptFlex-F_Cu.gbr, ptFlex-F_Mask.gbr, ptFlex-F_Paste.gbr]
2025-09-27 Adjusting gitignore
    [ptFlex-job.gbrjob]
2026-04-12 Finalizing PCB v2.0.2. Including some minor tweaks to the firmware as well.
    [Bill of Materials.csv, ptFlex.kicad_pcb, ptFlex.kicad_sch]
2026-05-18 Updated BOM parts
    [ptFlex.kicad_pcb, ptFlex.kicad_sch]
2026-05-18 Added logic to handle invalid gps fix.
    [ptFlex.ino]
2026-05-31 Limiting GPS debug noise
    [GPS.cpp, ptFlex.ino]
2026-05-31 Fix for GPS Delay being out of order in config strings
    [ptConfig.cpp]
