custom-ds/ptFlex/(notices)

Notices in the files:
firmware/ptFlex/ptConfig.h:
This program is free software: you can redistribute it and/or modify it under the terms of the GNU General Public License as published by
the Free Software Foundation, either version 3 of the License, or (at your option) any later version.
parts and their libraries:
SparkFun-FreqCtrl: Licensing: CC v3.0 Share-Alike You are welcome to use this library for commercial purposes.
SparkFun-Sensors: Licensing: Creative Commons ShareAlike 4.0 International - https://creativecommons.org/licenses/by-sa/4.0
